FredericChasse/Testbench_PCB/Photos/Testbench_1.jpg

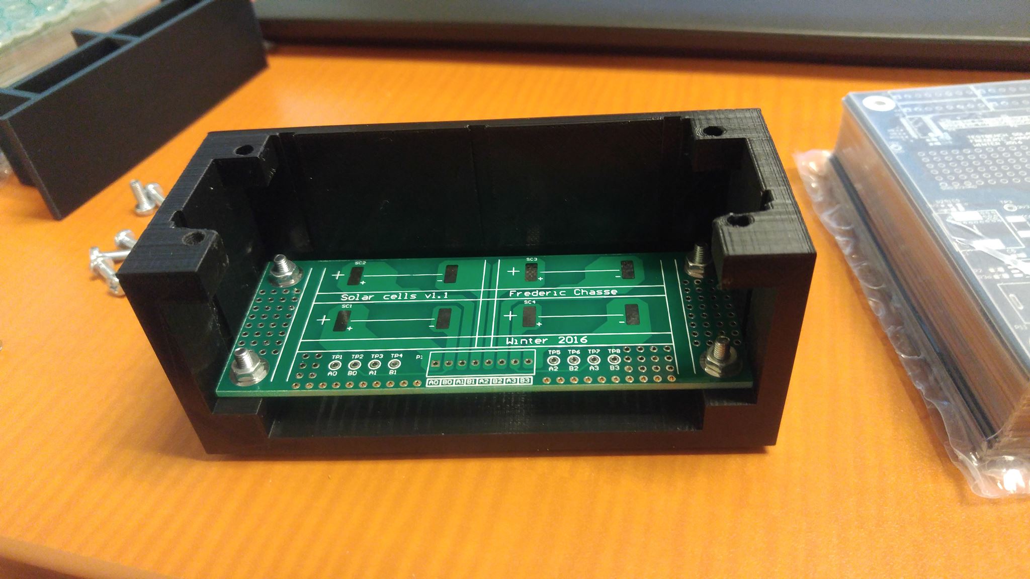
Photos/Testbench_1.jpg
