FredericChasse/Testbench_PCB/Photos/Testbench_2.jpg

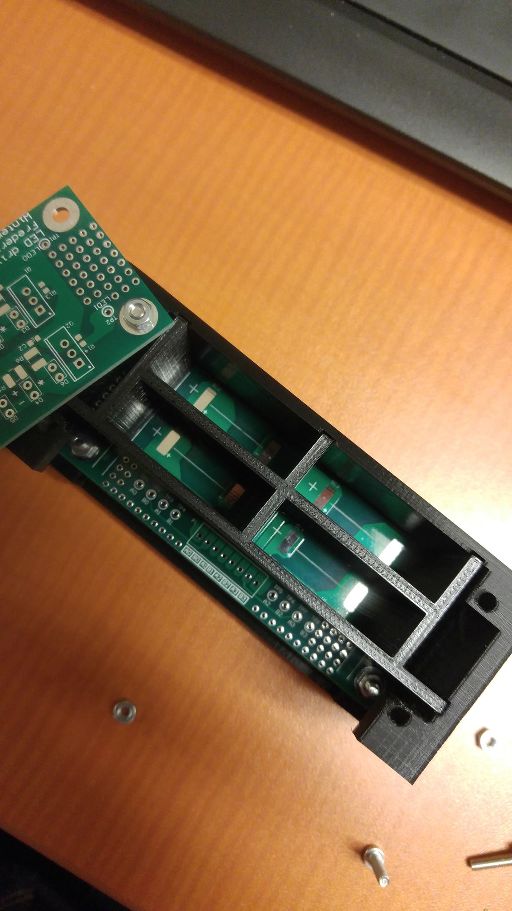
Photos/Testbench_2.jpg
