FredericChasse/Testbench_PCB/README.md

# Testbench_PCB
Schematics of the testbench

Also contains some MATLAB files used is SYS843
