FredericChasse/Testbench_PCB/solar_board/IDFReport_top_level.html

Altium customize

# IDF File Translation Report

Date: | | 2016-01-17
Time: | | 8:56:39 PM
Elapsed Time: | | 00:00:00
PCB Filename | : | C:\Users\ironi\Documents\ETS\Maîtrise\Benchtest solaire\solar_board\top_level.PcbDoc
IDF Board Filename | : | C:\Users\ironi\Documents\ETS\Maîtrise\Benchtest solaire\solar_board\top_level.brd
IDF Library Filename | : | C:\Users\ironi\Documents\ETS\Maîtrise\Benchtest solaire\solar_board\top_level.pro

Errors

Back to top

Warnings

Back to top

Save Warnings

Back to top

Save Errors

Back to top

Export Warnings

Back to top

Export Errors

Back to top
