FredericChasse/Testbench_PCB/ACQ_board.PNG

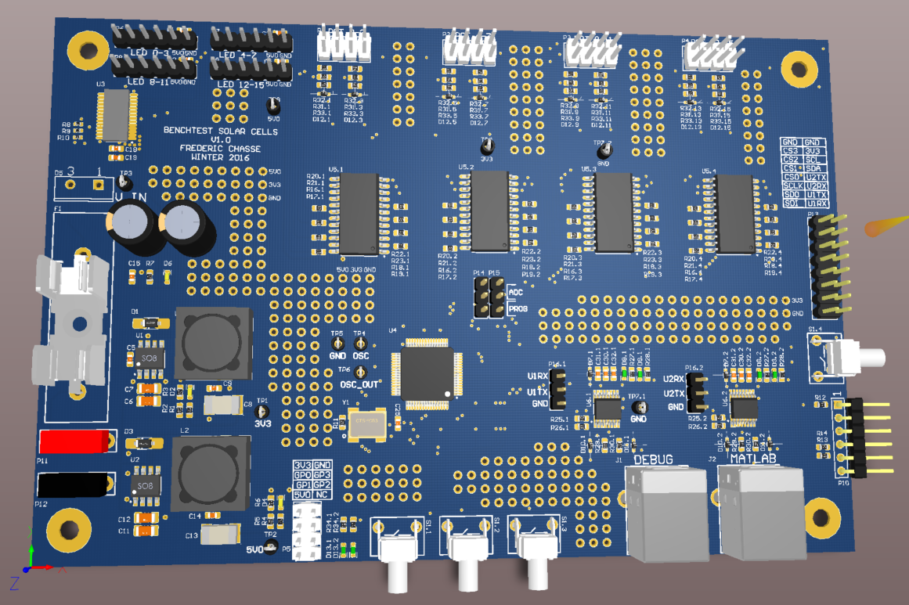
ACQ_board.PNG
