FredericChasse/Testbench_PCB/LED_board.png

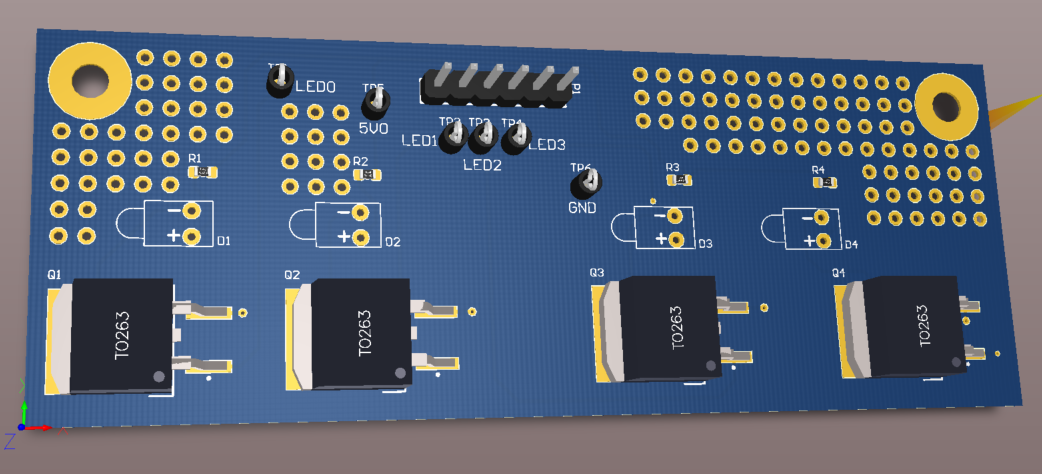
LED_board.png
