FredericChasse/Testbench_PCB/MATLAB/4cells/dc3.jpg

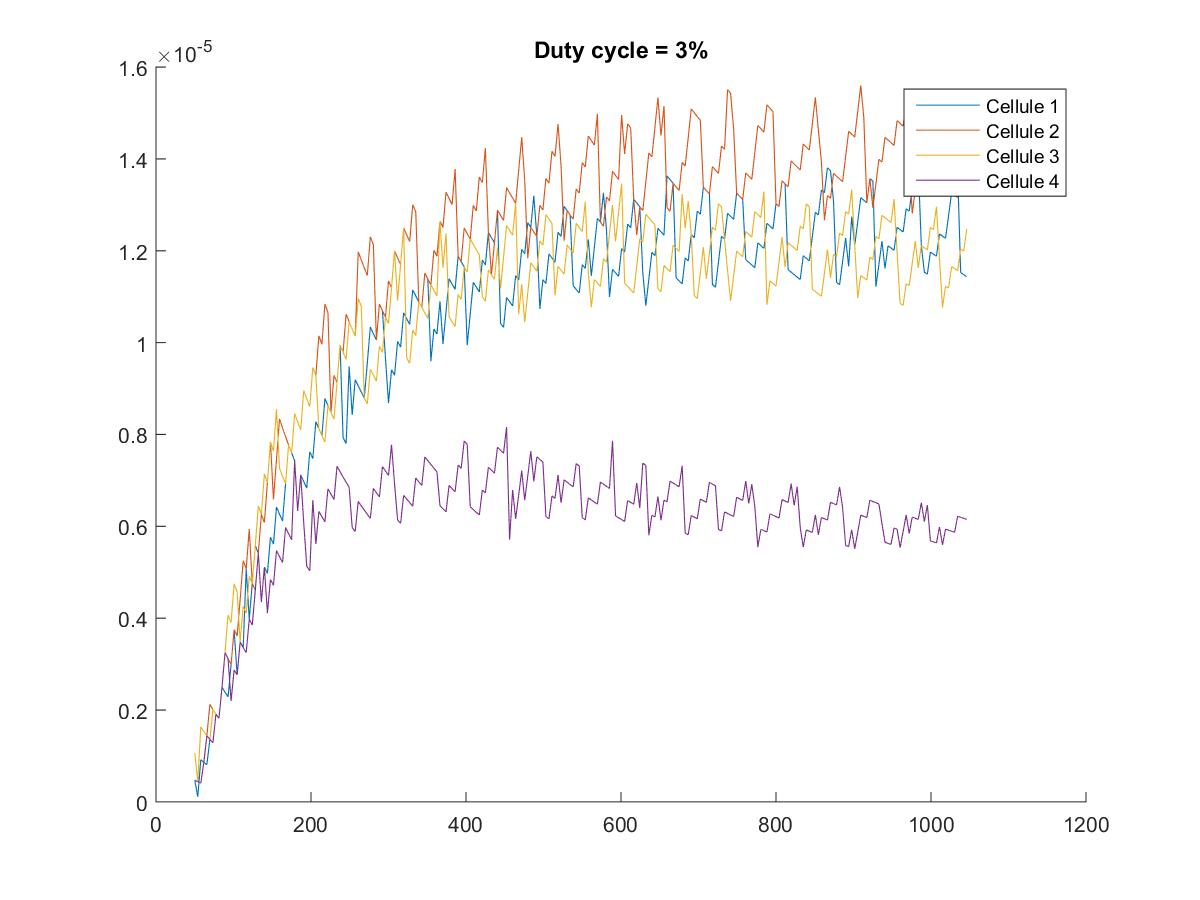
MATLAB/4cells/dc3.jpg
