FredericChasse/Testbench_PCB/MATLAB/4cells/dc5.jpg

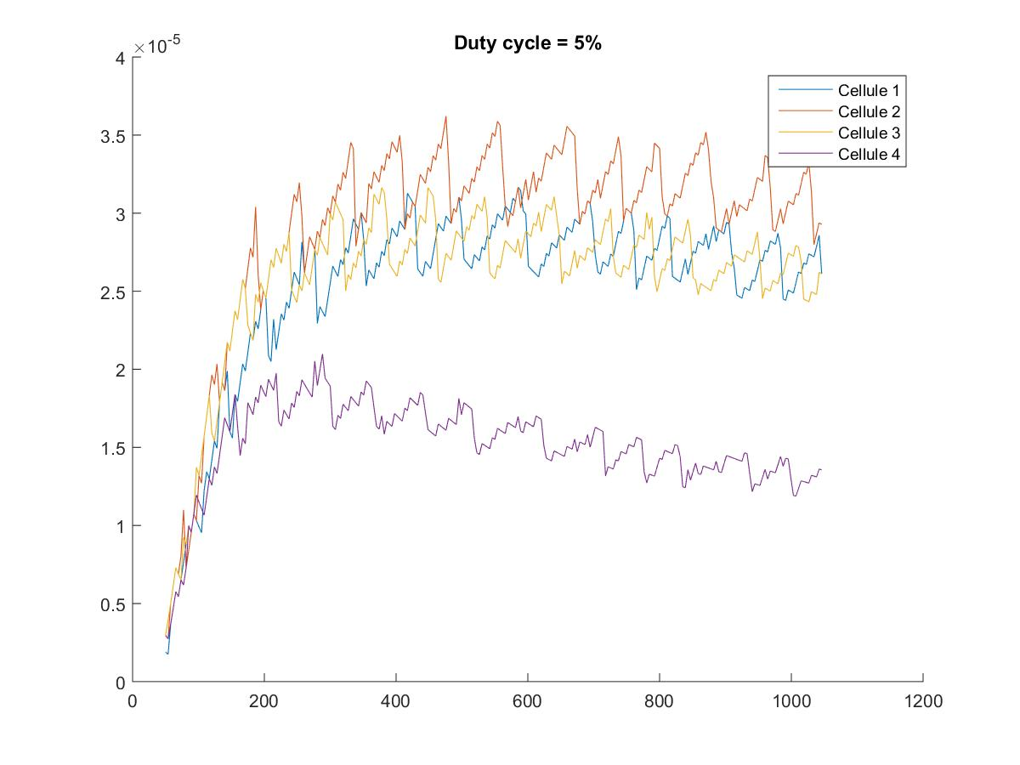
MATLAB/4cells/dc5.jpg
