FredericChasse/Testbench_PCB/MATLAB/4cells/dc10.jpg

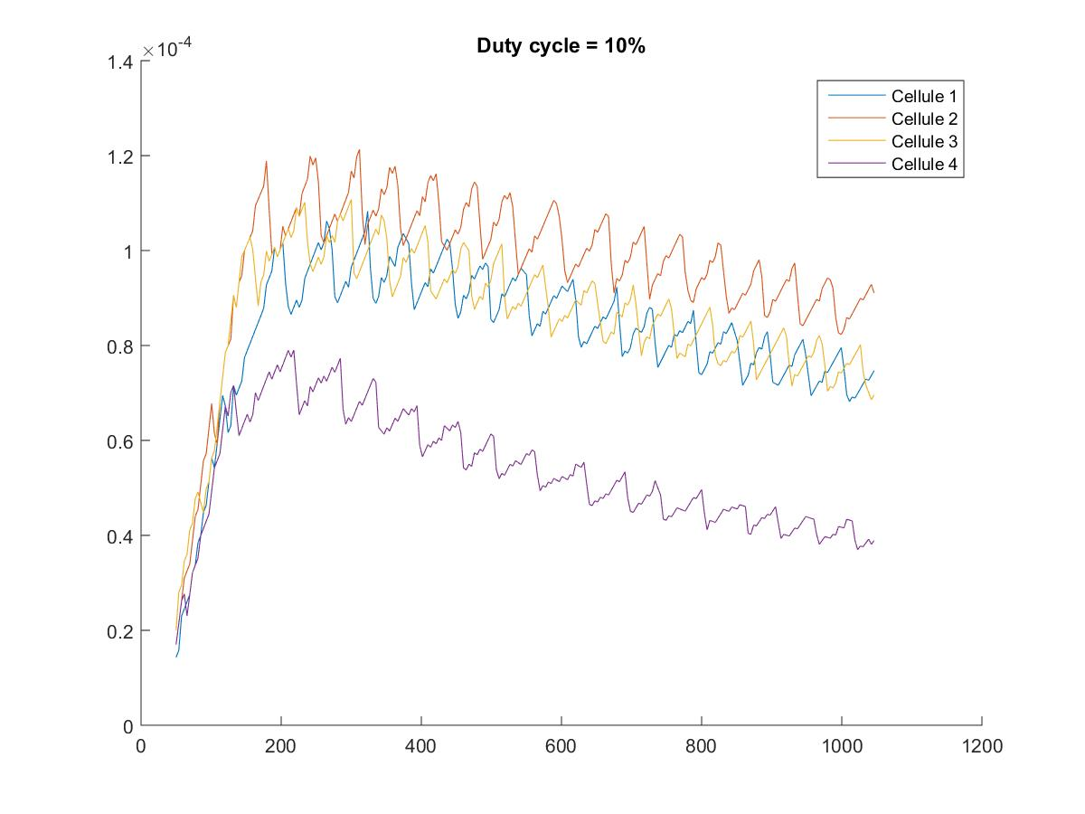
MATLAB/4cells/dc10.jpg
