FredericChasse/Testbench_PCB/MATLAB/4cells/dc15.jpg

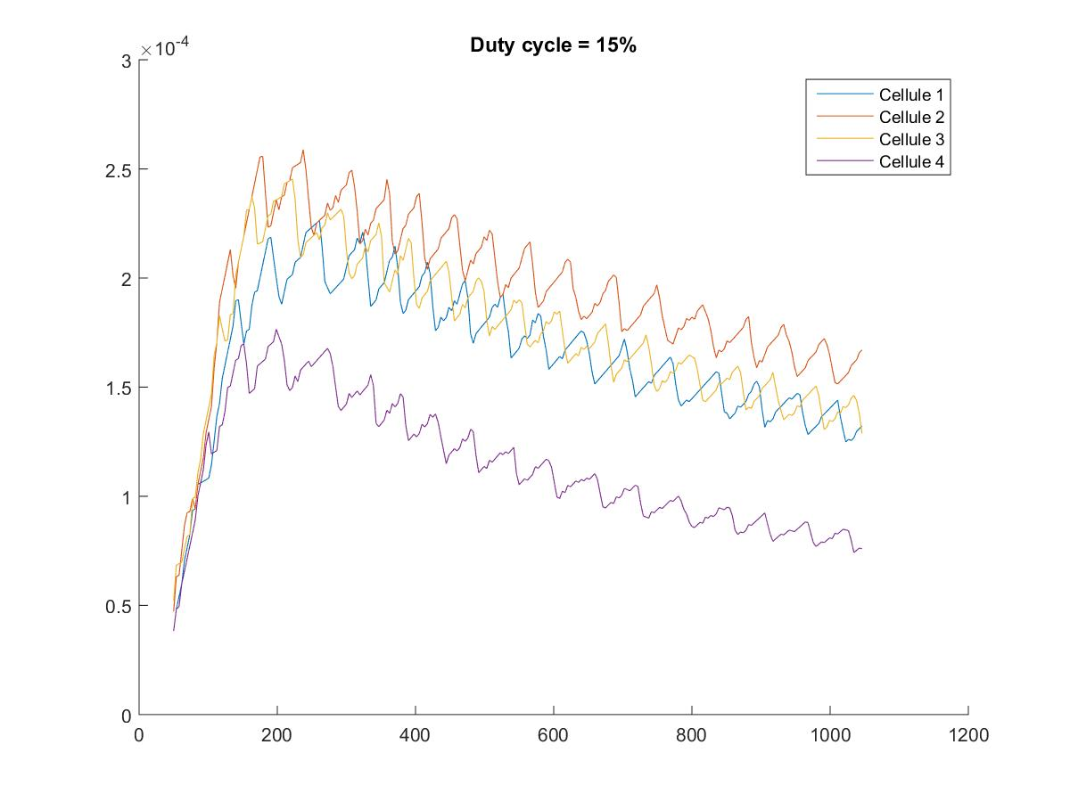
MATLAB/4cells/dc15.jpg
