FredericChasse/Testbench_PCB/MATLAB/4cells/dc20.jpg

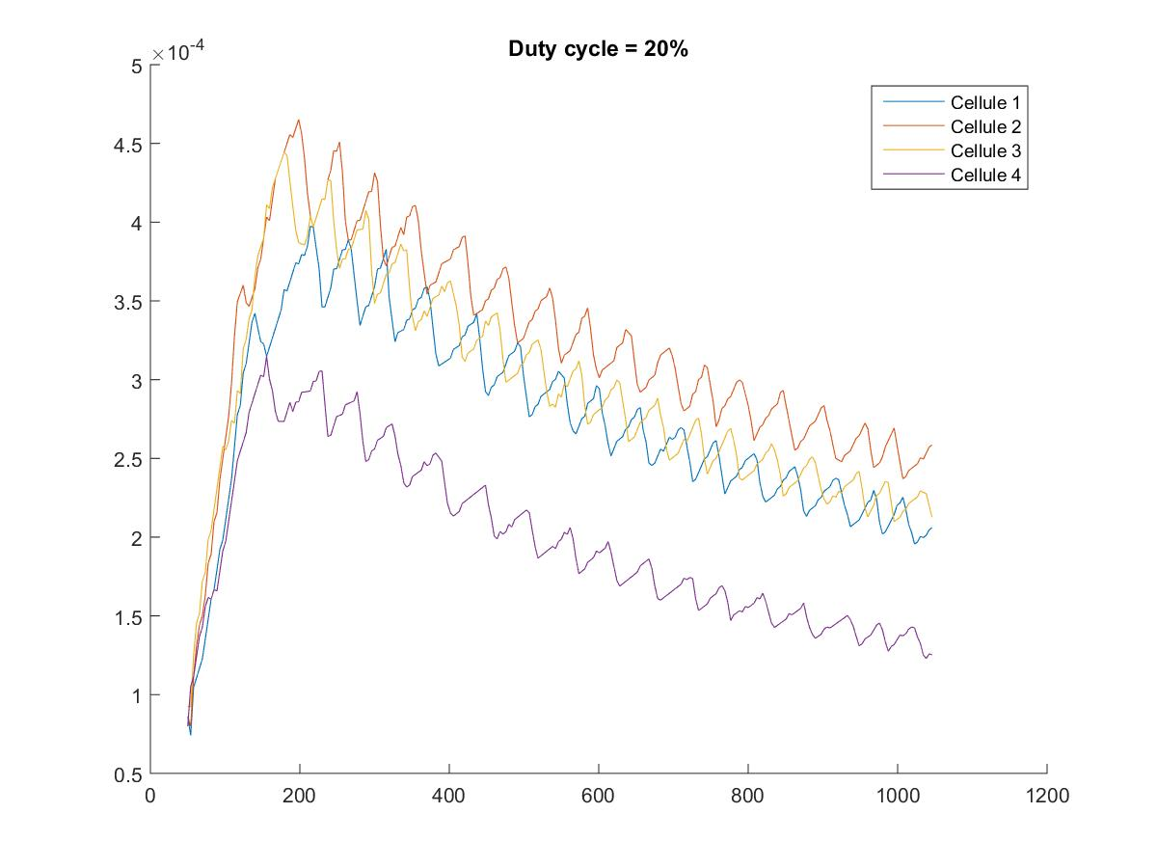
MATLAB/4cells/dc20.jpg
