FredericChasse/Testbench_PCB/MATLAB/4cells/dc30.jpg

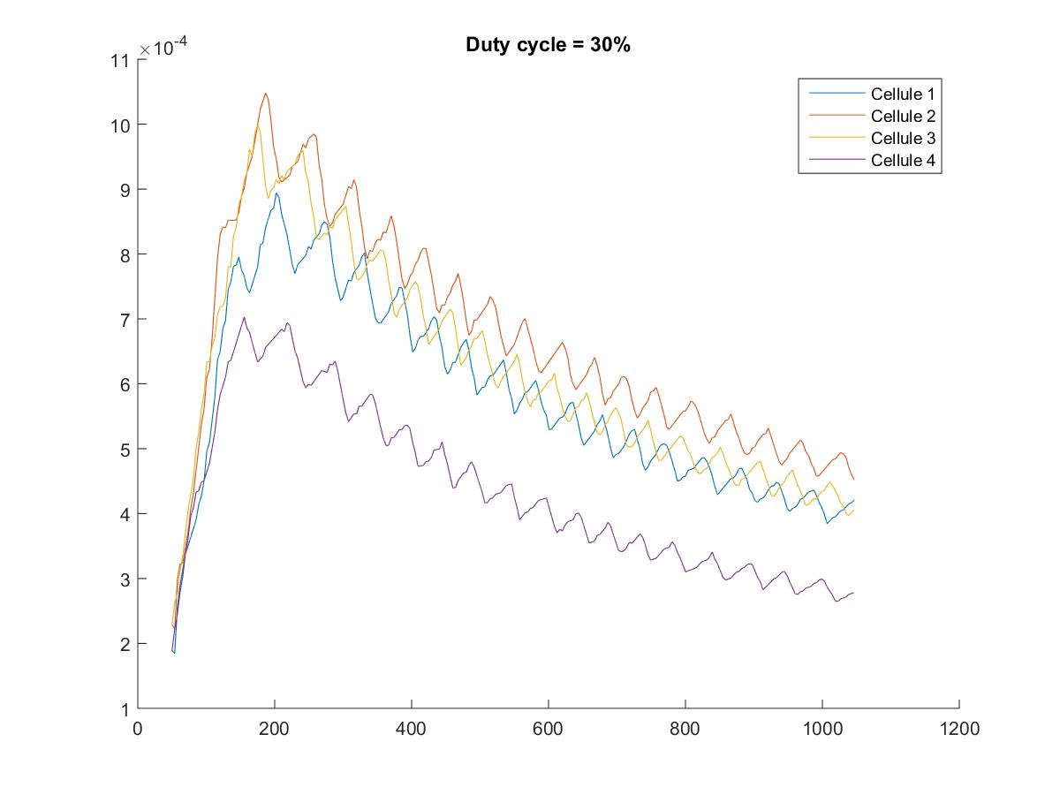
MATLAB/4cells/dc30.jpg
