FredericChasse/Testbench_PCB/MATLAB/4cells/dc40.jpg

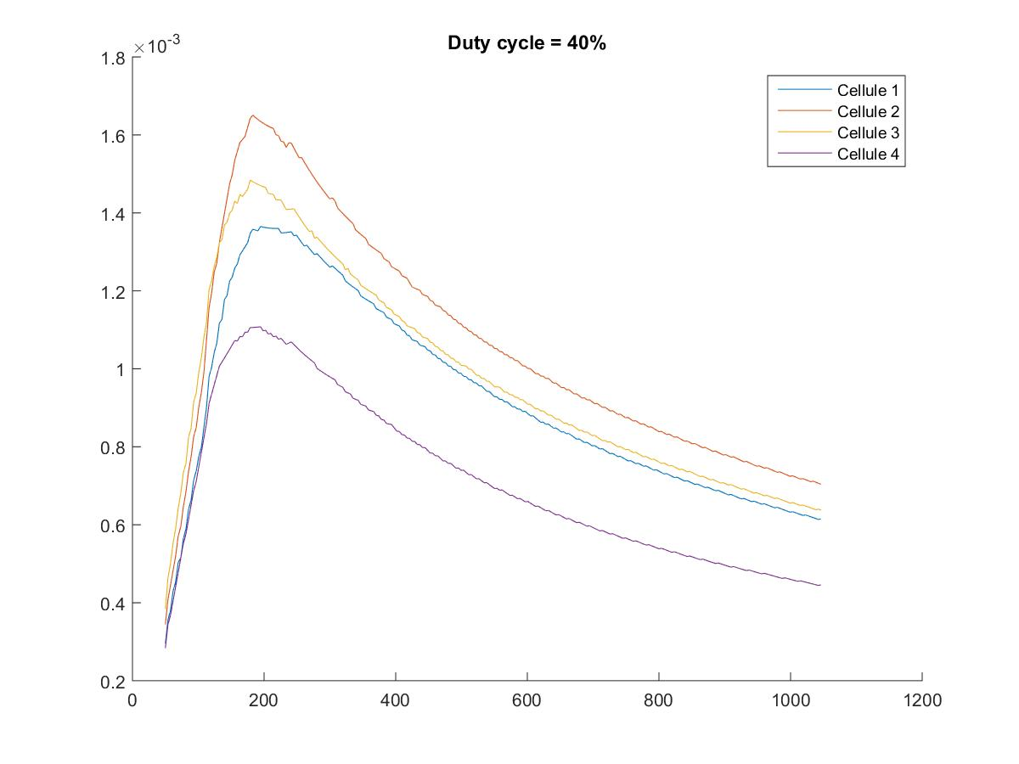
MATLAB/4cells/dc40.jpg
