FredericChasse/Testbench_PCB/MATLAB/dc2_5.jpg

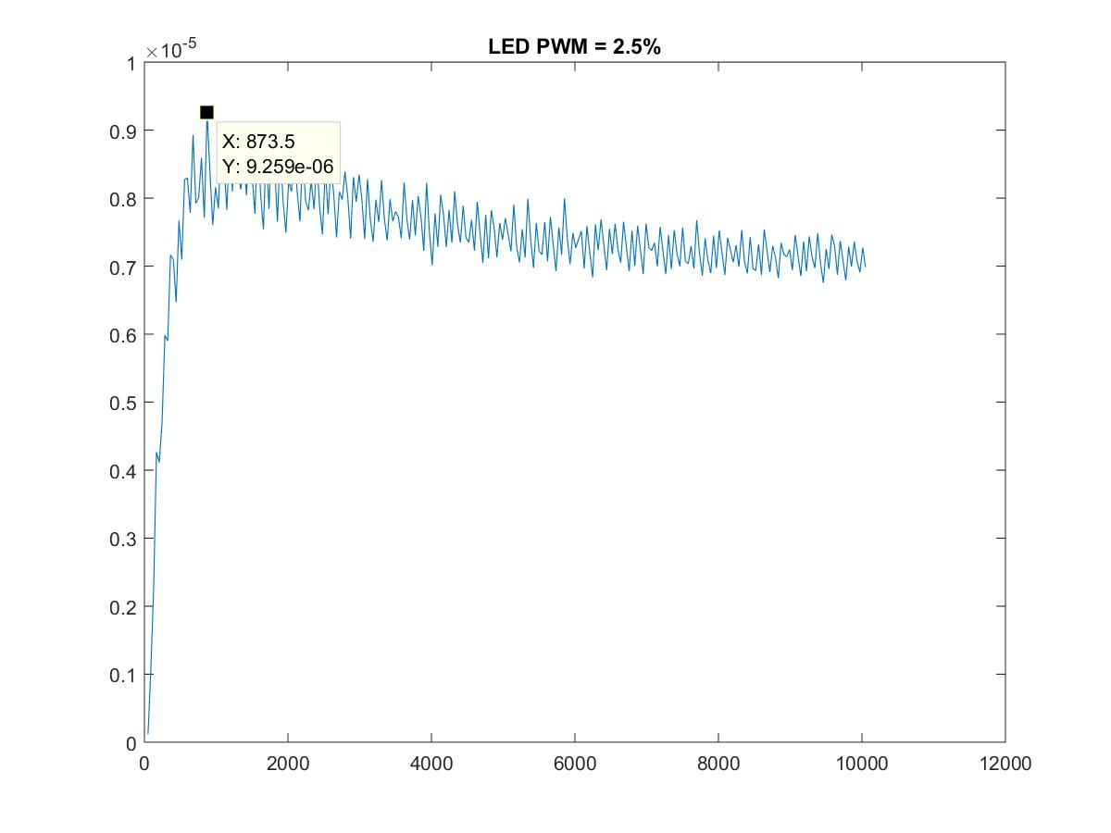
MATLAB/dc2_5.jpg
