FredericChasse/Testbench_PCB/MATLAB/dc5.jpg

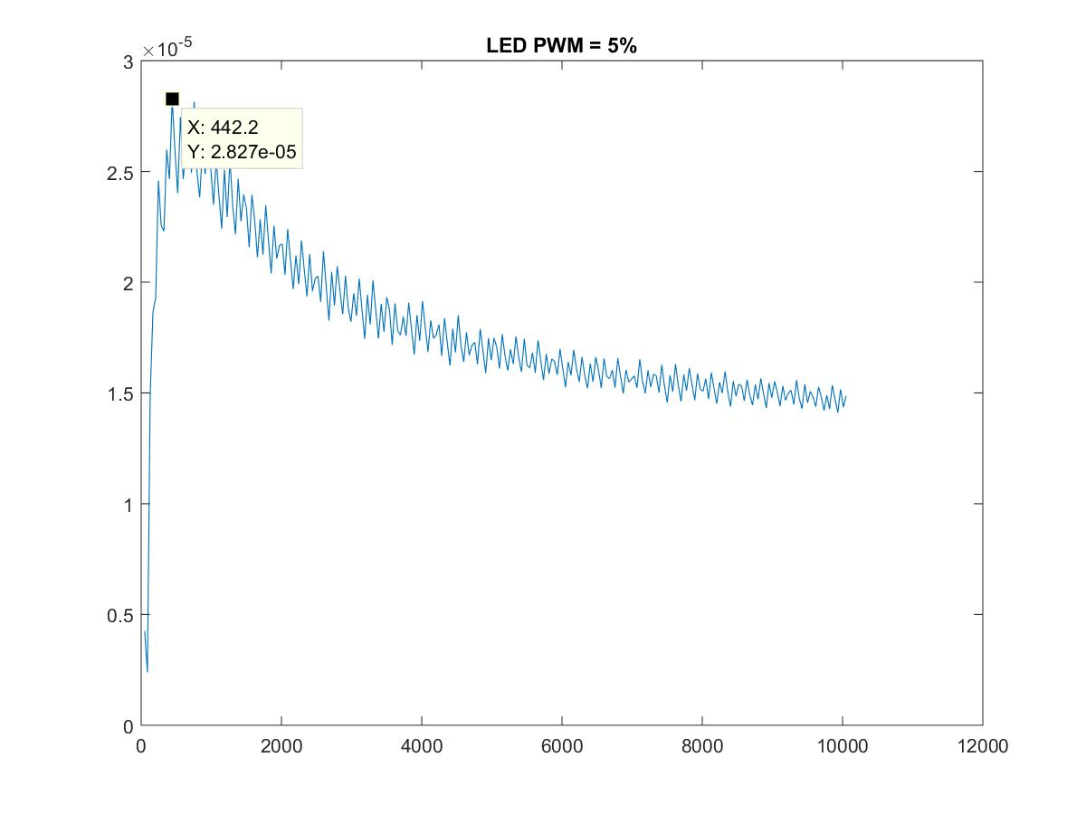
MATLAB/dc5.jpg
