FredericChasse/Testbench_PCB/MATLAB/dc10.jpg

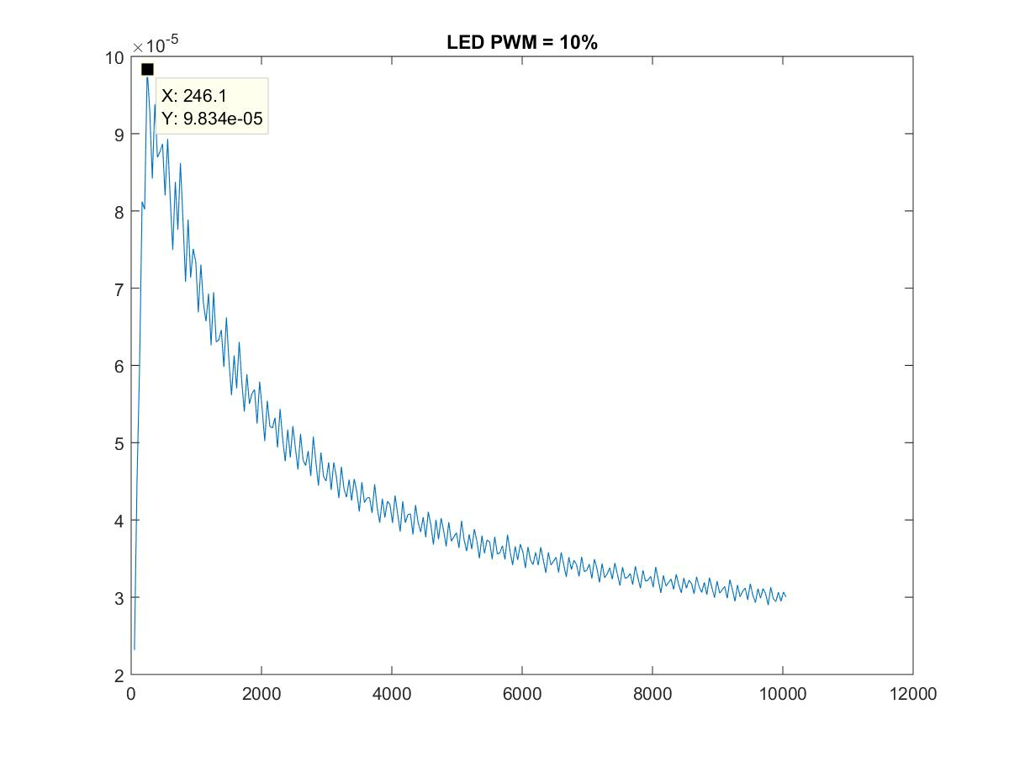
MATLAB/dc10.jpg
