FredericChasse/Testbench_PCB/MATLAB/dc20.jpg

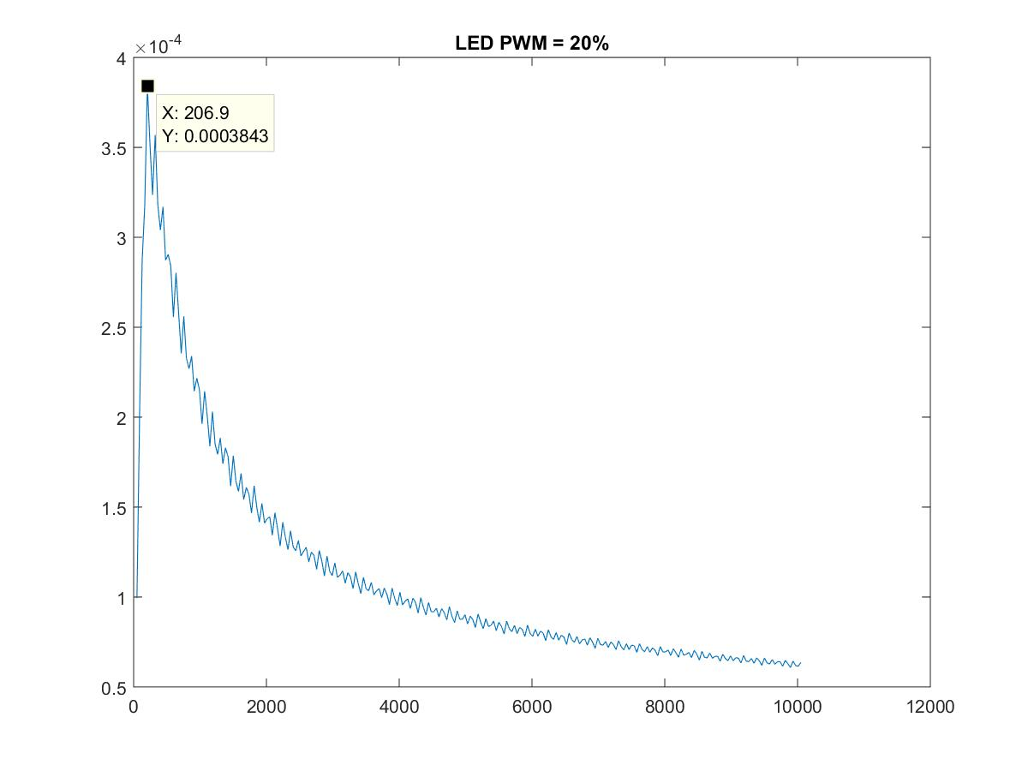
MATLAB/dc20.jpg
