FredericChasse/Testbench_PCB/MATLAB/dc30.jpg

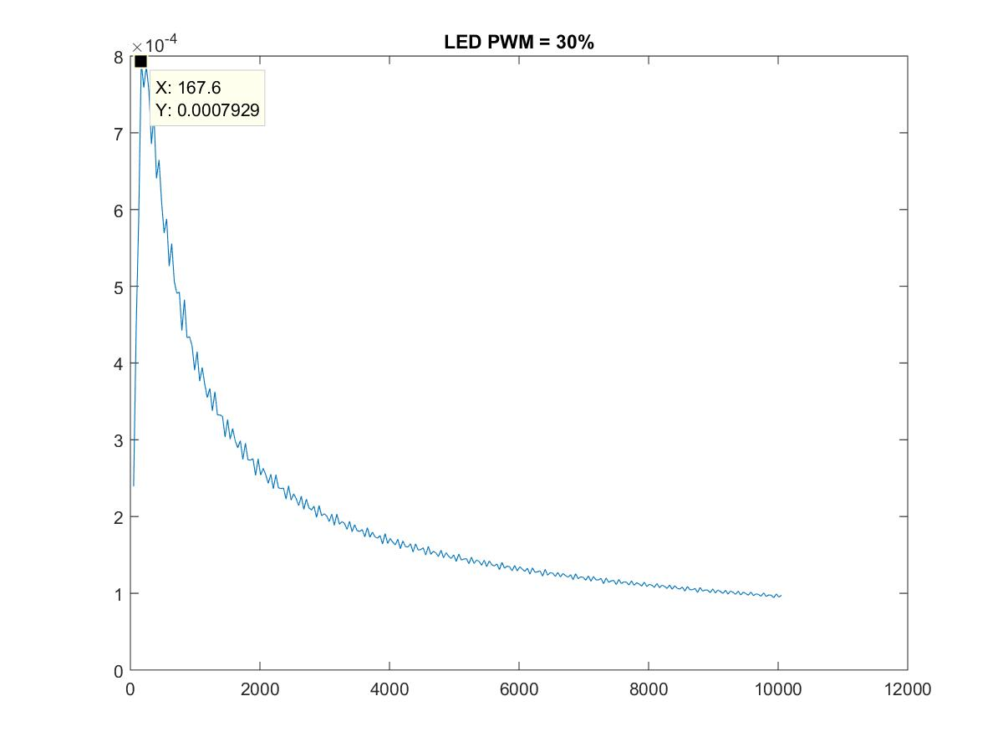
MATLAB/dc30.jpg
