FredericChasse/Testbench_PCB/MATLAB/dc50.jpg

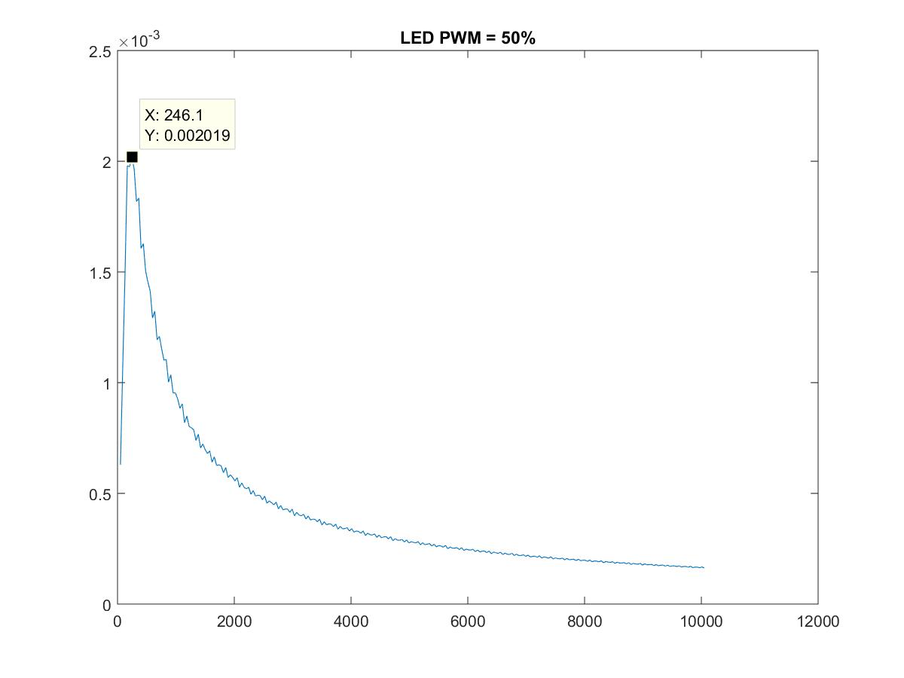
MATLAB/dc50.jpg
