FredericChasse/Testbench_PCB/MATLAB/pot1k/dc20.jpg

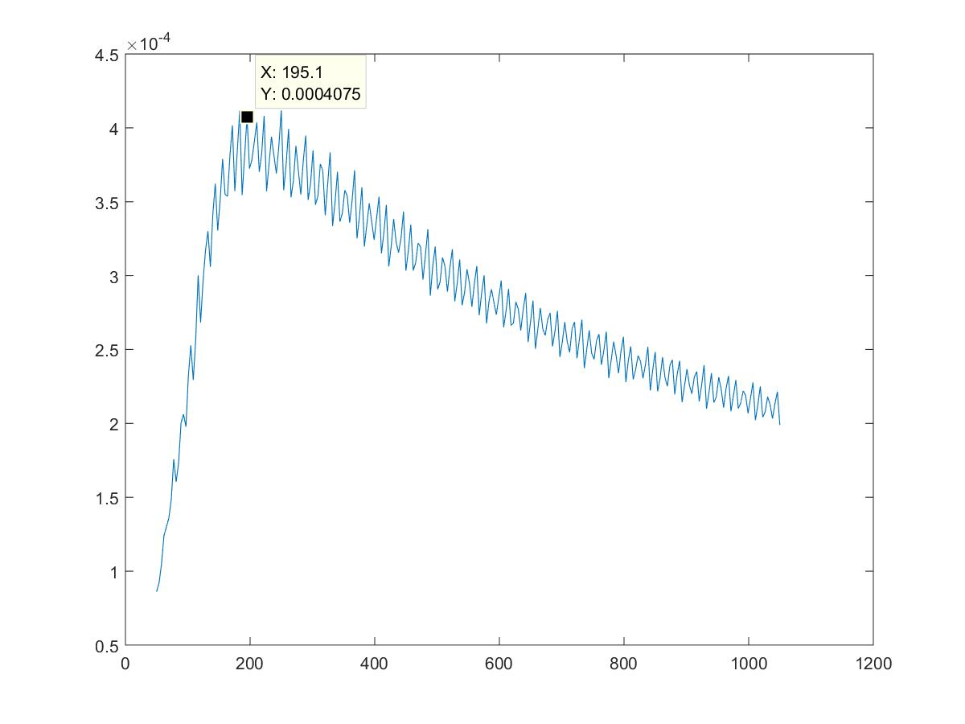
MATLAB/pot1k/dc20.jpg
