FredericChasse/Testbench_PCB/MATLAB/pot1k/dc40.jpg

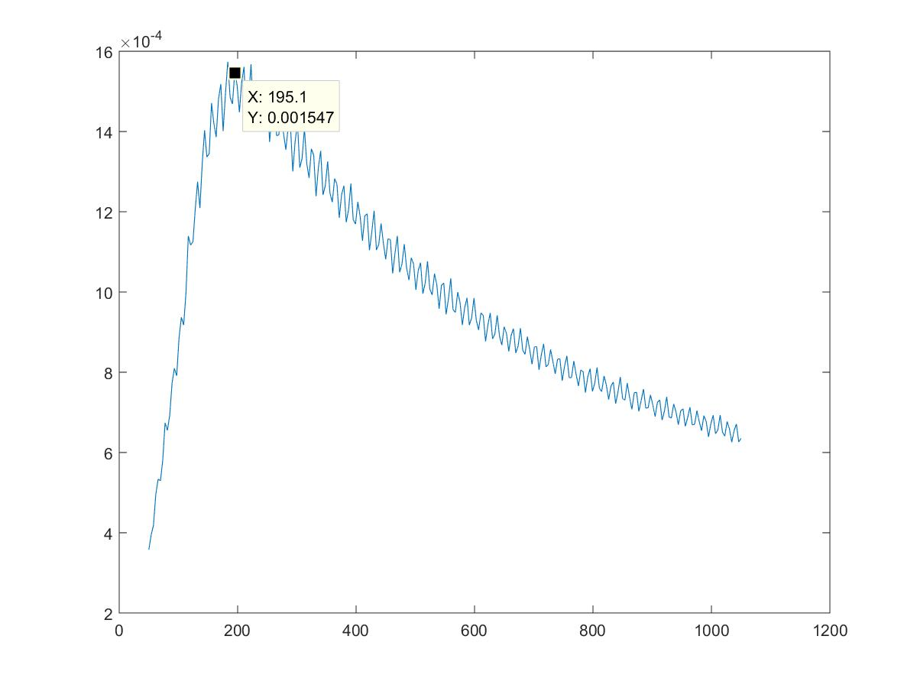
MATLAB/pot1k/dc40.jpg
