FredericChasse/Testbench_PCB/MATLAB/pot1k/dc50.jpg

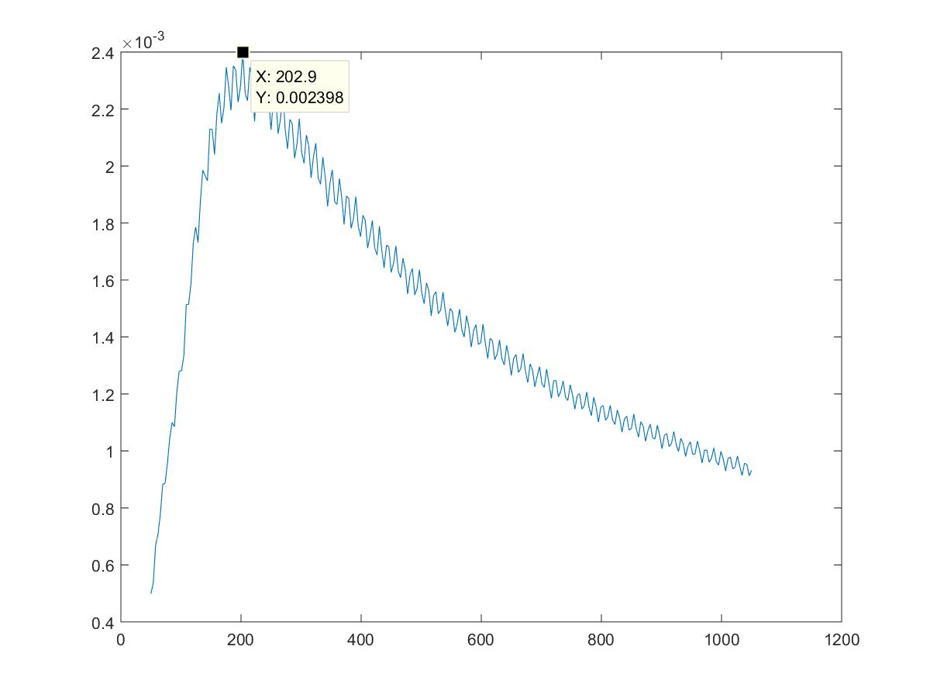
MATLAB/pot1k/dc50.jpg
