FredericChasse/Testbench_PCB/Photos/PCBs.jpg

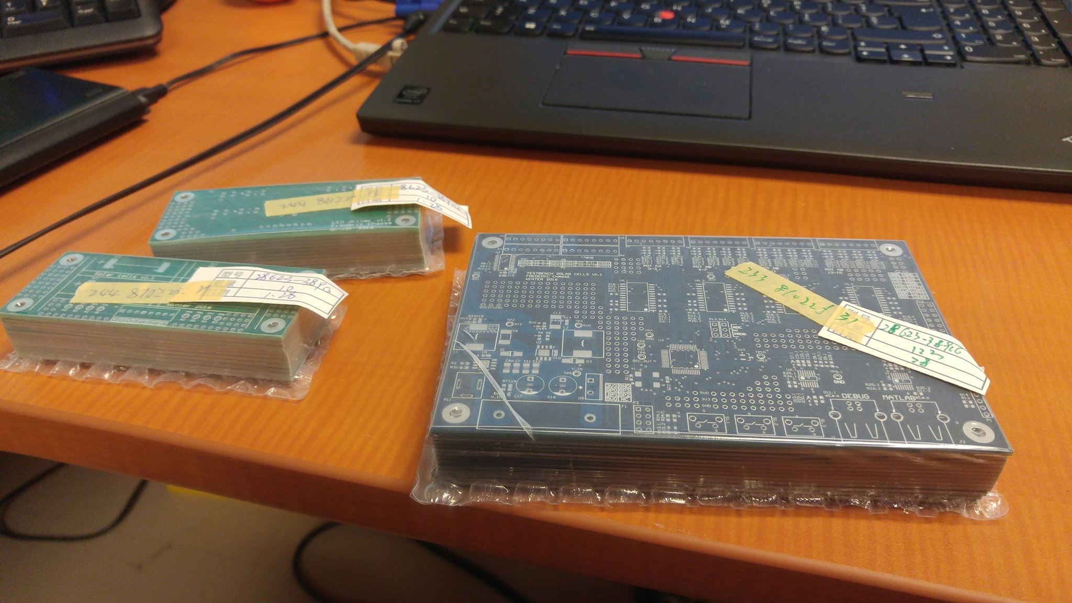
Photos/PCBs.jpg
