FredericChasse/Testbench_PCB/Solar_cells_board.PNG

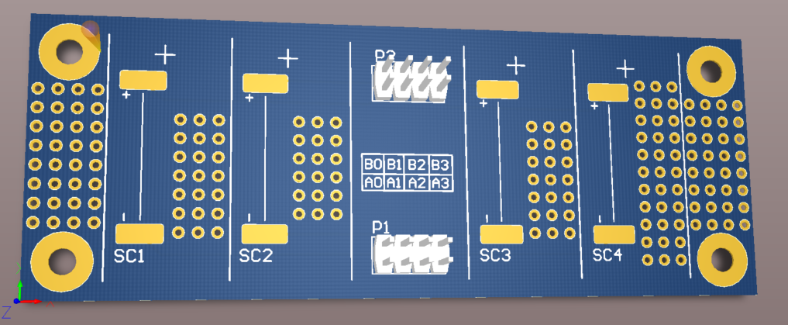
Solar_cells_board.PNG
