FredericChasse/Testbench_PCB/Solidworks/top view.PNG

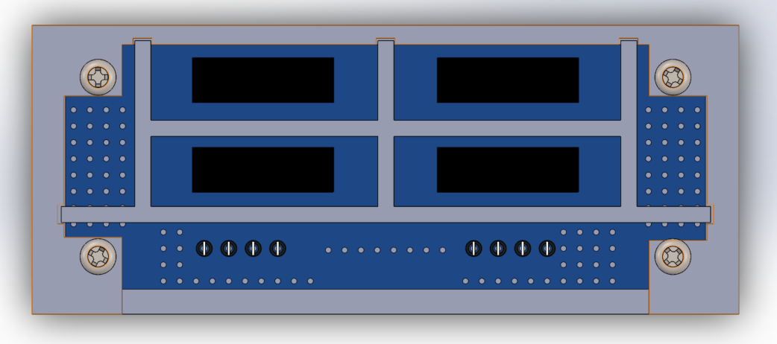
Solidworks/top view.PNG
