FredericChasse/Testbench_PCB/BOM.xlsx

Comment | Description | Designator | Footprint | LibRef | Manufacturer | Part Number | Quantity | DocumentName | Supplier 1 | Supplier 2 | Supplier Part Number 1 | Supplier Part Number 2 | VALUE
CON - HEADER 1X8 | 100mil header 1 row 6 pins | P3, P4, P5, P6, P7, P8, P9, P10 | CON-HEADER-1X8 | CON - HEADER 1X8 |  |  | 8 | ControlBoard.SchDoc | Digi-Key |  | A1924-ND
CON - HEADER 2X4 | 100mil header 2 row 8pins | P2 | CON-HEADER-2X4 | CON - HEADER 2X4 |  |  | 1 | ControlBoard.SchDoc | Digi-Key |  | 952-2122-ND
CON - HEADER 2X8 | 100mil header 2 row 16pins | P12 | CON-HEADER-2X8 | CON - HEADER 2X8 |  |  | 1 | ControlBoard.SchDoc | Digi-Key |  | 952-2128-ND
CON - HEADER PROG | MICROCHIP CONNECTOR | P1 | CON-HEADER-1X6-RA | CON - PROG HEADER 6 |  |  | 1 | ControlBoard.SchDoc | Digi-Key |  | S9016E-06-ND
CON - POWER CONNECTOR | CONN PWR JACK 2.1X5.5MM HIGH CUR | P11 | CON-POWER CONNECTOR | CON - POWER CONNECTOR |  |  | 1 | ControlBoard.SchDoc | Digi-Key |  | CP-002AH-ND
USB 4 pins | 4 pin USB connector with 2 shield pins | J1, J2 | CON-USB TYPE B | CON - USB TYPE B 4 pins | FCI |  | 2 | ControlBoard.SchDoc | Digi-Key |  | 609-3656-ND
CS - CAPACITOR | CAP CER 10000PF 50V 10% X7R 0603 | C1, C2, C3, C4, C5, C9, C10, C14, C15, C18, C19, C20, C21, C22, C23, C24, C25, C26, C27, C28.1, C28.2, C28.3, C28.4, C29.1, C29.2, C29.3, C29.4, C30.1, C30.2, C31.1, C31.2, C32.1, C32.2, C33 | CS-0603 | CS - CAPACITOR | TDK |  | 34 | ControlBoard.SchDoc, ControlBoard.SchDoc, ControlBoard.SchDoc, ControlBoard.SchDoc, DC-DC.SchDoc, DC-DC.SchDoc, DC-DC.SchDoc, DC-DC.SchDoc, DC-DC.SchDoc, LED_Controller.SchDoc, LED_Controller.SchDoc, PIC32MX_circuit.SchDoc, PIC32MX_circuit.SchDoc, PIC32MX_circuit.SchDoc, PIC32MX_circuit.SchDoc, PIC32MX_circuit.SchDoc, PIC32MX_circuit.SchDoc, PIC32MX_circuit.SchDoc, PIC32MX_circuit.SchDoc, Potentiometer.SchDoc, Potentiometer.SchDoc, Potentiometer.SchDoc, Potentiometer.SchDoc, Push_Button.SchDoc, Push_Button.SchDoc, Push_Button.SchDoc, Push_Button.SchDoc, USB-UART.SchDoc, USB-UART.SchDoc, USB-UART.SchDoc, USB-UART.SchDoc, USB-UART.SchDoc, USB-UART.SchDoc, Vref.SchDoc | Digikey |  | 445-1311-1-ND, 490-1532-1-ND |  | 100n, 100n, 100n, 100n, 10nF, 100n, 10nF, 100n, 1uF, 100n, 100n, 100n, 100n, 100n, 100n, 100n, 100n, 10u, 100n, 100n, 100n, 100n, 100n, 100n, 100n, 100n, 100n, 4.7u, 4.7u, 100n, 100n, 100n, 100n, 100n
5003K |  | TP1, TP2, TP3, TP4, TP5, TP6, TP7, TP8, TP9.1, TP9.2, TP10 | TP - VERTICAL | TP - Test point vertical |  |  | 11 | ControlBoard.SchDoc, ControlBoard.SchDoc, DC-DC.SchDoc, DC-DC.SchDoc, DC-DC.SchDoc, PIC32MX_circuit.SchDoc, PIC32MX_circuit.SchDoc, PIC32MX_circuit.SchDoc, USB-UART.SchDoc, USB-UART.SchDoc, Vref.SchDoc | Newark, Digikey |  | 62W5140, 5004K-ND
B340A-13-F | DIODE SCHOTTKY 40V 3A SMA | D1, D3 | DS-DO-214AC-SMA | DS - Schottky | Diodes Incorporated |  | 2 | DC-DC.SchDoc | Digikey | Digi-Key | B340A-FDICT-ND | B340A-FDICT-ND (https://octopart-clicks.com/click/altium?sku=B340A-FDICT-ND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)
CS - CAPACITOR |  | C6, C7, C11, C12 | CS-1206 | CS - CAPACITOR | Samsung |  | 4 | DC-DC.SchDoc | Digikey |  | 587-2994-1-ND |  | 4.7uF
CS - CAPACITOR POL |  | C8, C13 | CS-2312 | CS - CAPACITOR POL |  |  | 2 | DC-DC.SchDoc |  | Digi-Key | 478-5236-2-ND | 478-5236-1-ND (https://octopart-clicks.com/click/altium?sku=478-5236-1-ND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) | 220u
CT - CAPACITOR ELECTROLYTIC |  | C16, C17 | CT-CAP-ALUM-8X14 | CT - CAPACITOR ELECTROLYTIC |  |  | 2 | DC-DC.SchDoc |  | Digi-Key | 493-13402-ND |  | 100uF
DT - Diode | Zener Schottky | D5 | TO-220AC | Diode 18TQ045 |  |  | 1 | DC-DC.SchDoc |  | Digi-Key | MBR1645-E3/45GI-ND | MBR1645-E3/45GI-ND (https://octopart-clicks.com/click/altium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)
FT - Fuse |  | F1 | FT - 5mm x 20mm | FT - Fuse | Schurter Inc |  | 1 | DC-DC.SchDoc | Digikey |  | 486-1259-ND
IC - TPS5430 | IC REG BUCK ADJ 3A 8SOPWRPAD | U1, U2 | IC-SOIC8-POWERPAD | IC - TPS5430 | Texas Instruments | TPS5430 | 2 | DC-DC.SchDoc | Digi-Key |  | 296-26988-1-ND
LED - NORMAL LED |  | D2, D4, D6 | LED-0603 YELLOW | LED - NORMAL LED |  |  | 3 | DC-DC.SchDoc |  | Digi-Key | 160-1445-1-ND
LS - INDUCTOR | INDUCTOR SHIELD PWR | L1, L2 | LS-Inductor SMD | LS - INDUCTOR | Bourns Inc |  | 2 | DC-DC.SchDoc | Digikey |  | SRR1260-330M |  | 33uH
RS - RESISTOR |  | R1, R2, R3, R4, R5, R6, R7, R11, R12, R13, R14, R15, R16.1, R16.2, R16.3, R16.4, R17.1, R17.2, R17.3, R17.4, R18.1, R18.2, R18.3, R18.4, R19.1, R19.2, R19.3, R19.4, R20.1, R20.2, R20.3, R20.4, R21.1, R21.2, R21.3, R21.4, R22.1, R22.2, R22.3, R22.4, R23.1, R23.2, R23.3, R23.4, R24.1, R24.2, R24.3, R24.4, R25.1, R25.2, R26.1, R26.2, R27.1, R27.2, R28.1, R28.2, R29.1, R29.2, R30.1, R30.2, R31.1, R31.2, R31.3, R31.4, R31.5, R31.6, R31.7, R31.8, R31.9, R31.10, R31.11, R31.12, R31.13, R31.14, R31.15, R32.1, R32.2, R32.3, R32.4, R32.5, R32.6, R32.7, R32.8, R32.9, R32.10, R32.11, R32.12, R32.13, R32.14, R32.15, R33.1, R33.2, R33.3, R33.4, R33.5, R33.6, R33.7, R33.8, R33.9, R33.10, R33.11, R33.12, R33.13, R33.14, R33.15, R34.1, R34.2, R35 | RS-0603 | RS - RESISTOR |  |  | 108 | DC-DC.SchDoc, DC-DC.SchDoc, DC-DC.SchDoc, DC-DC.SchDoc, DC-DC.SchDoc, DC-DC.SchDoc, DC-DC.SchDoc, PIC32MX_circuit.SchDoc, PIC32MX_circuit.SchDoc, PIC32MX_circuit.SchDoc, PIC32MX_circuit.SchDoc, PIC32MX_circuit.SchDoc, Potentiometer.SchDoc, Potentiometer.SchDoc, Potentiometer.SchDoc, Potentiometer.SchDoc, Potentiometer.SchDoc, Potentiometer.SchDoc, Potentiometer.SchDoc, Potentiometer.SchDoc, Potentiometer.SchDoc, Potentiometer.SchDoc, Potentiometer.SchDoc, Potentiometer.SchDoc, Potentiometer.SchDoc, Potentiometer.SchDoc, Potentiometer.SchDoc, Potentiometer.SchDoc, Potentiometer.SchDoc, Potentiometer.SchDoc, Potentiometer.SchDoc, Potentiometer.SchDoc, Potentiometer.SchDoc, Potentiometer.SchDoc, Potentiometer.SchDoc, Potentiometer.SchDoc, Potentiometer.SchDoc, Potentiometer.SchDoc, Potentiometer.SchDoc, Potentiometer.SchDoc, Potentiometer.SchDoc, Potentiometer.SchDoc, Potentiometer.SchDoc, Potentiometer.SchDoc, Push_Button.SchDoc, Push_Button.SchDoc, Push_Button.SchDoc, Push_Button.SchDoc, USB-UART.SchDoc, USB-UART.SchDoc, USB-UART.SchDoc, USB-UART.SchDoc, USB-UART.SchDoc, USB-UART.SchDoc, USB-UART.SchDoc, USB-UART.SchDoc, USB-UART.SchDoc, USB-UART.SchDoc, USB-UART.SchDoc, USB-UART.SchDoc, Signal_Protection.SchDoc, Signal_Protection.SchDoc, Signal_Protection.SchDoc, Signal_Protection.SchDoc, Signal_Protection.SchDoc, Signal_Protection.SchDoc, Signal_Protection.SchDoc, Signal_Protection.SchDoc, Signal_Protection.SchDoc, Signal_Protection.SchDoc, Signal_Protection.SchDoc, Signal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 |  |  | http://www.digikey.ca/product-search/en/resistors/chip-resistor-surface-mount/65769?k=resistor |  | 130, 10K, 5.90K, 300, 10K, 3.24K, 2K, 10k, 100, 47, 47, 0, 0, 0, 0, 0, 0, 0, 0, 0, 0, 0, 0, 0, 0, 0, 0, 0, 0, 0, 0, 0, 0, 0, 0, 0, 0, 0, 0, 0, 0, 0, 0, 0, 10k, 10k, 10k, 10k, 10k, 10k, 10k, 10k, 130, 130, 130, 130, 27, 27, 27, 27, [NoValue], [NoValue], [NoValue], [NoValue], [NoValue], [NoValue], [NoValue], [NoValue], [NoValue], [NoValue], [NoValue], [NoValue], [NoValue], [NoValue], [NoValue], 0, 0, 0, 0, 0, 0, 0, 0, 0, 0, 0, 0, 0, 0, 0, [NoValue], [NoValue], [NoValue], [NoValue], [NoValue], [NoValue], [NoValue], [NoValue], [NoValue], [NoValue], [NoValue], [NoValue], [NoValue], [NoValue], [NoValue], 130, 130, 300R0
IC - PCA9685 | 16-channel, 12-bit PWM Fm + I2C-bus LED controller | U3 | IC-TSSOP-28 | IC - PCA9685 | Allegro |  | 1 | LED_Controller.SchDoc | Digi-Key |  | 568-11925-2-ND
RS - RESISTOR |  | R8, R9, R10 | RS-0402 | RS - RESISTOR |  |  | 3 | LED_Controller.SchDoc |  |  | http://www.digikey.ca/product-search/en/resistors/chip-resistor-surface-mount/65769?k=resistor |  | 10k, 4.7k, 4.7k
8MHz | Oscillator | Y1 | OSC-CB3LV | OSC - CB3LV |  |  | 1 | PIC32MX_circuit.SchDoc | Digi-Key |  | CTX264LVCT-ND
CON - HEADER 1X3 | 100mil header 1 row 3pins | P13, P14 | CON-HEADER-1X3 | CON - HEADER 1X3 |  |  | 2 | PIC32MX_circuit.SchDoc | Digi-Key |  | S1212EC-03-ND
IC - PIC32MX795F512HT-80I/PT |  | U4 | IC-TQFP-64 | IC - PIC32MX795F512HT-80I/PT | Microchip |  | 1 | PIC32MX_circuit.SchDoc | Digi-Key |  | PIC32MX795F512H-80I/PT-ND
IC - AD8403 | DIGITAL POTENTIOMETER | U5.1, U5.2, U5.3, U5.4 | IC-SOIC-24 | IC - AD8403 |  |  | 4 | Potentiometer.SchDoc | Digi-Key |  | AD8403ARZ10-ND
SW - Tactile Switch |  | S1.1, S1.2, S1.3, S1.4 | SW-FSMRA | SW - Tactile Switch |  |  | 4 | Push_Button.SchDoc | Digi-Key | Digi-Key | 450-1658-ND | 450-1758-2-ND (https://octopart-clicks.com/click/altium?sku=450-1758-2-ND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)
DS - TVS ESD5Z3.3T1G | TVS 3.3V | D12.1, D12.2, D12.3, D12.4, D12.5, D12.6, D12.7, D12.8, D12.9, D12.10, D12.11, D12.12, D12.13, D12.14, D12.15 | DS-SOD523 | DS - TVS ESD5Z3.3T1G | ON Semiconductor |  | 15 | Signal_Protection.SchDoc | Digi-Key |  | ESD5Z3.3T1GOSCT-ND
DS - TVS ESD5Z5.0T1G | TVS 5V | D7.1, D7.2, D10.1, D10.2, D11.1, D11.2 | DS-SOD523 | DS - TVS ESD5Z5.0T1G | ON Semiconductor |  | 6 | USB-UART.SchDoc |  | Digi-Key | ESD5Z5.0T1GOSTR-ND | ESD5Z5.0T1GOSCT-ND (https://octopart-clicks.com/click/altium?sku=ESD5Z5.0T1GOSCT-ND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)
IC - FT230XS | USB to BASIC UART IC | U6.1, U6.2 | IC-SSOP-16 | IC - FT230XS | FTDI |  | 2 | USB-UART.SchDoc | Digi-Key |  | 768-1154-5-ND
LED - NORMAL LED |  | D8.1, D8.2, D9.1, D9.2, D13.1, D13.2 | LED-0603 GREEN | LED - NORMAL LED |  |  | 6 | USB-UART.SchDoc, USB-UART.SchDoc, USB-UART.SchDoc, USB-UART.SchDoc, LED_debug.SchDoc, LED_debug.SchDoc |  | Digi-Key | 160-1446-1-ND
DS - LM4040 | Zener Diode Vref | D14 | IC-SOT-23 | DS - LM4040 |  |  | 1 | Vref.SchDoc | Digi-Key |  | LM4040EIM3-2.5/NOPBCT-ND
Solar_board
Comment | Description | Designator | Footprint | LibRef | Quantity | Supplier 1 | Supplier Part Number 1
CON - HEADER 1X8 | 100mil header 1 row 6 pins | P1 | CON-HEADER-1X8 | CON - HEADER 1X8 | 1 | Digi-Key | A1924-ND
RS - RESISTOR VARIABLE |  | SC1, SC2, SC3, SC4 | SC - KXOB22-04X3L | RS - RESISTOR VARIABLE | 4 | Digikey | KXOB22-04X3L-ND
5003K |  | TP1, TP2, TP3, TP4, TP5, TP6, TP7, TP8 | TP - VERTICAL | TP - Test point vertical | 8 | Newark | 62W5140
Led_board
Comment | Description | Designator | Footprint | LibRef | Quantity | Supplier name | Supplier Part Number | VALUE | Supplier 1 | Supplier Part Number 1
CT - CAPACITOR ELECTROLYTIC |  | C1 | CT-CAP-ALUM-8X14 | CT - CAPACITOR ELECTROLYTIC | 1 | Digikey | 493-13402-ND | 100uF | Digikey | 493-13402-ND
CS - CAPACITOR |  | C2, C3, C4, C5 | CS-0603 | CS - CAPACITOR | 4 |  |  | 100n | Digikey | 445-1311-1-ND, 490-1532-1-ND
LED - NORMAL LED |  | D1, D2, D3, D4, D5, D6, D7, D8 | LED-1 | LED - NORMAL LED | 12 |  |  |  | Digikey | VLCS5830-ND
CON - HEADER 1X8 | 100mil header 1 row 6 pins | P1 | CON-HEADER-1X8 | CON - HEADER 1X8 | 1 |  |  |  | Digi-Key | A1924-ND
MOSFET-N | N-Channel MOSFET | Q1, Q2, Q3, Q4 | TO-220AB | MOSFET-N | 4 | Digikey | IRFI530NPBF-ND
RS - RESISTOR |  | R1, R2, R3, R4, R5, R6, R7, R8 | RS-1210 | RS - RESISTOR | 12 |  |  | 28 | Digikey | P28.0AACT-ND
RS - RESISTOR |  | R9, R10, R11, R12 | RS-0603 | RS - RESISTOR | 4 |  |  | 10k | Digikey | http://www.digikey.ca/product-search/en/resistors/chip-resistor-surface-mount/65769?k=resistor
5003K |  | TP1, TP2, TP3, TP4, TP5, TP6 | TP - VERTICAL | TP - Test point vertical | 6 |  |  |  | Newark | 62W5140
 | http://www.digikey.ca/short/373v85
 | http://www.digikey.ca/short/37qtdv | shortened
 | http://www.digikey.ca/short/37z8nf | without samples
 | http://www.digikey.ca/short/37h0h9 | 56 ohm
 | http://www.digikey.ca/short/3t77rm
