FredericChasse/Testbench_PCB/solar_board/Project Outputs for solar_board/solar_board.xlsx

Comment | Description | Designator | Footprint | LibRef | Quantity | Supplier 1 | Supplier Part Number 1
CON - HEADER 1X8 | 100mil header 1 row 6 pins | P1 | CON-HEADER-1X8 | CON - HEADER 1X8 | 1 | Digi-Key | A1924-ND (https://octopart-clicks.com/click/altium?manufacturer=TE%20Connectivity%20AMP%20Connectors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)
RS - RESISTOR VARIABLE |  | SC1, SC2, SC3, SC4 | SC - KXOB22-04X3L | RS - RESISTOR VARIABLE | 4 | Digikey | KXOB22-04X3L-ND (https://octopart-clicks.com/click/altium?manufacturer=Supplier%20disabled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)
5003K |  | TP1, TP2, TP3, TP4, TP5, TP6, TP7, TP8 | TP - VERTICAL | TP - Test point vertical | 8 | Newark | 62W5140 (https://octopart-clicks.com/click/altium?sku=62W5140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)
