FredericChasse/Testbench_PCB/Solidworks/Parts.PNG

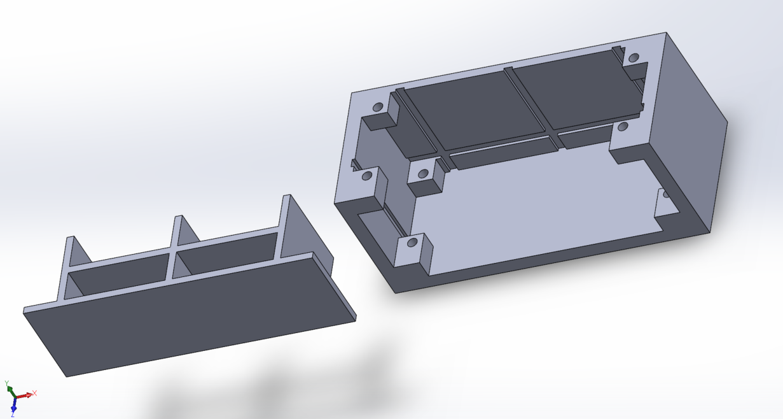
Solidworks/Parts.PNG
