FredericChasse/Testbench_PCB/Solidworks/Benchtest_assy.SLDASM

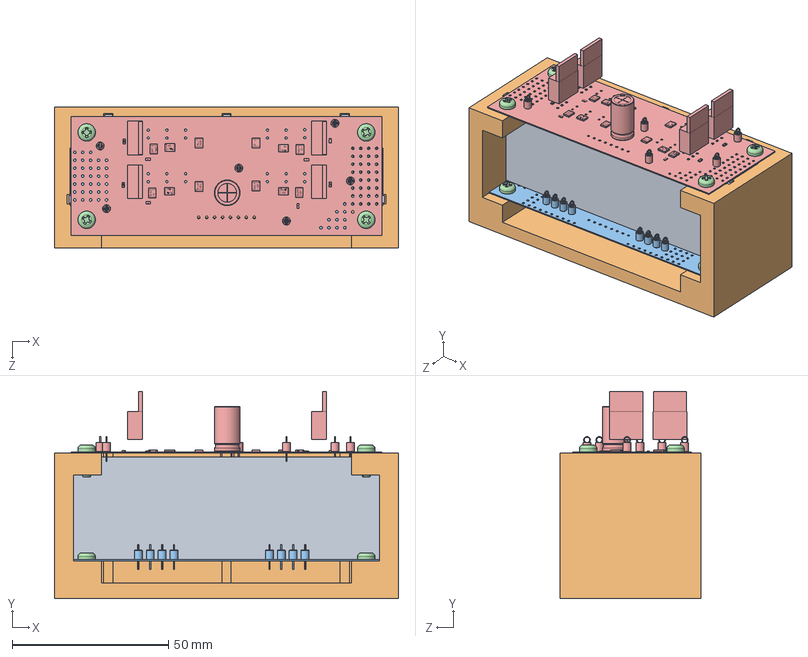
[picture p36: CAD file, 2017-02-09]
Solidworks/Benchtest_assy.SLDASM
110.0 x 66.2 x 45.0 mm
Separator
Benchtest - v1_0
Solar_board
PHT 3x8x7.5-type I-D-N x 8
LED_board
