FredericChasse/Testbench_PCB/parts/solar_cell.STEP

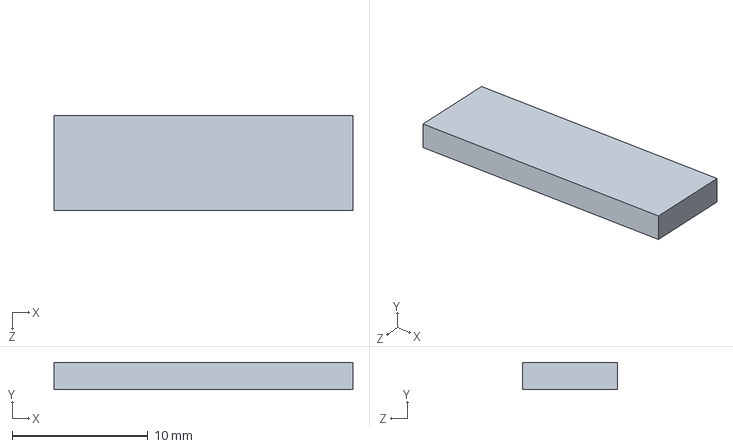
[picture p37: CAD file, 2017-02-09]
parts/solar_cell.STEP
22.0 x 2.00 x 7.00 mm
