FredericChasse/Testbench_PCB/solar_board/solar_board.step

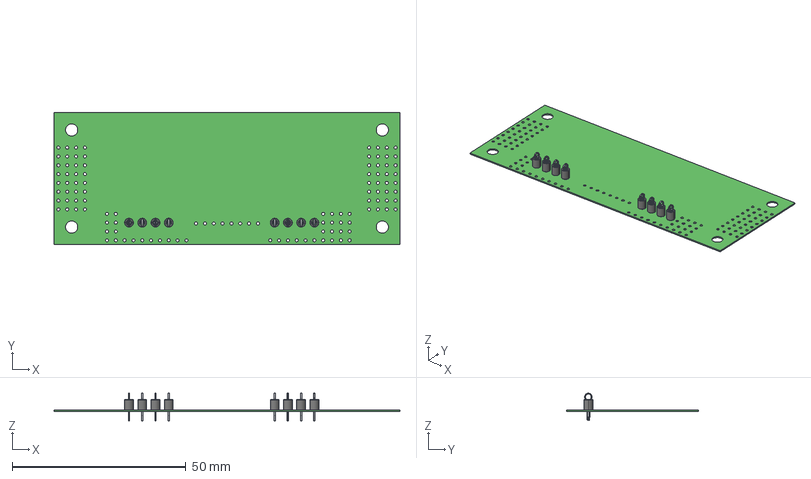
[picture p38: CAD file, 2017-02-09]
solar_board/solar_board.step
99.6 x 38.1 x 7.96 mm
Board
User_Library-TEST_POINT_BLK_Keystone_5001 x 8
