FredericChasse/Testbench_PCB/Solidworks/LED_board.SLDPRT

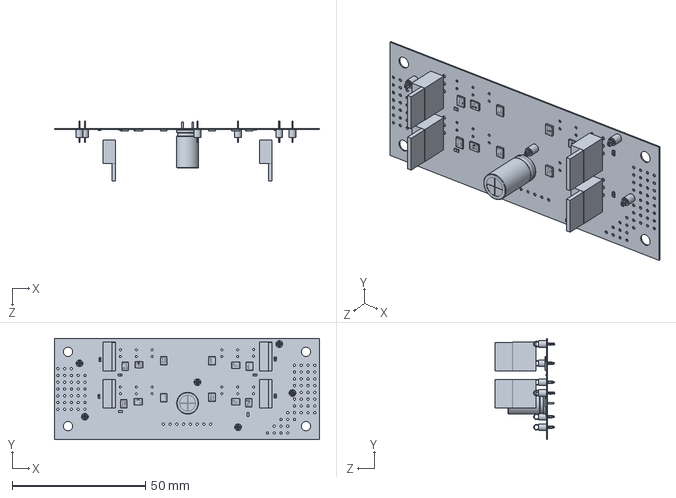
[picture p39: CAD file, 2017-02-09]
Solidworks/LED_board.SLDPRT
99.6 x 38.1 x 22.4 mm
