FredericChasse/Testbench_PCB/parts/pj-002ah.stp

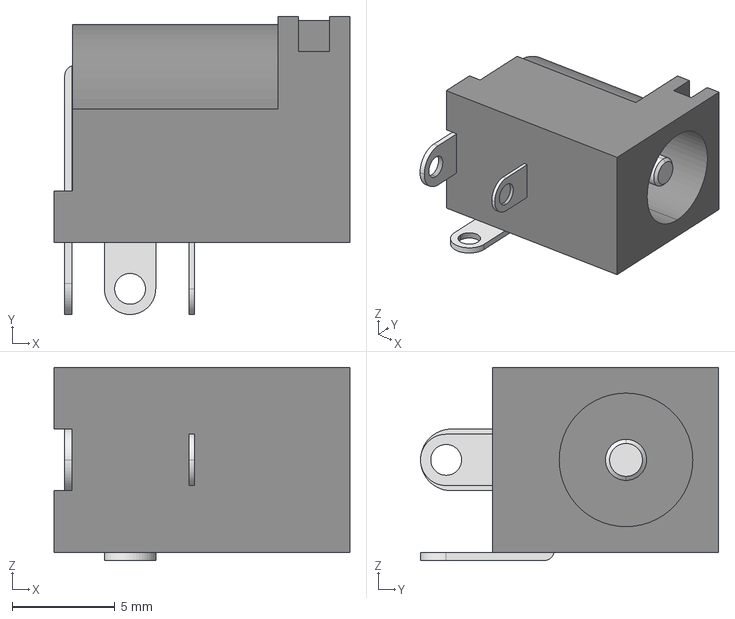
[picture p40: CAD file, 2017-02-09]
parts/pj-002ah.stp
14.4 x 14.5 x 9.40 mm
