FredericChasse/Testbench_PCB/solar_board/top_level_solar_cells.step

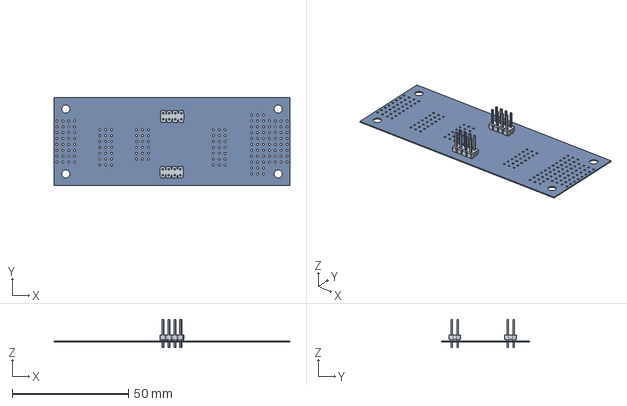
[picture p41: CAD file, 2017-02-09]
solar_board/top_level_solar_cells.step
101.6 x 38.1 x 12.2 mm
Board
CON___-_HEADER_MALE_2X4PINS x 34
