FredericChasse/Testbench_PCB/Solidworks/Base_part.STL

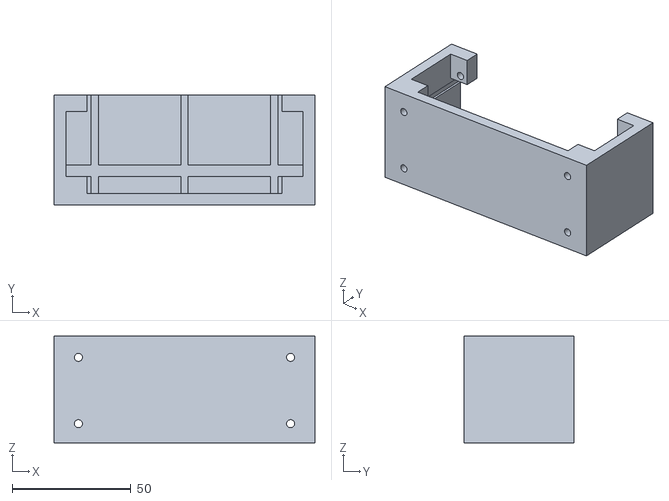
[picture p42: CAD file, 2017-02-09]
Solidworks/Base_part.STL
110.0 x 46.5 x 45.0
