FredericChasse/Testbench_PCB/Solidworks/Base_part_v2.STL

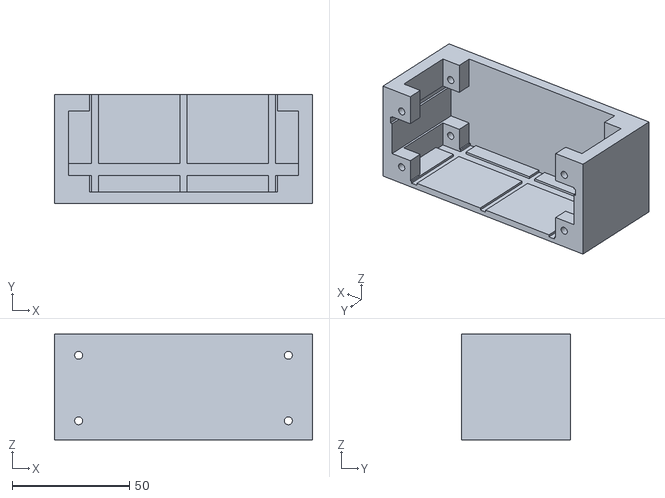
[picture p43: CAD file, 2017-02-09]
Solidworks/Base_part_v2.STL
110.0 x 46.5 x 45.0
