FredericChasse/Testbench_PCB/Solidworks/Solar_board.step

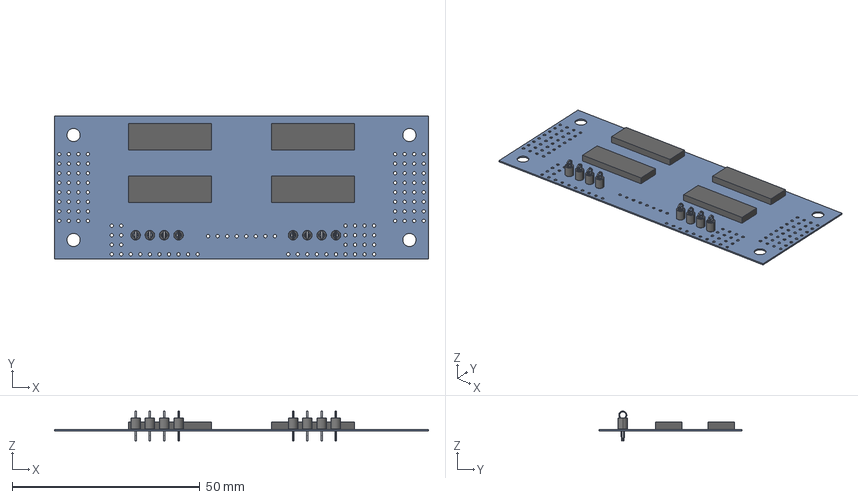
[picture p44: CAD file, 2017-02-09]
Solidworks/Solar_board.step
99.6 x 38.1 x 7.96 mm
Board
solar_cell x 4
User_Library-TEST_POINT_BLK_Keystone_5001 x 8
