FredericChasse/Testbench_PCB/Solidworks/Slide_in_part.STL

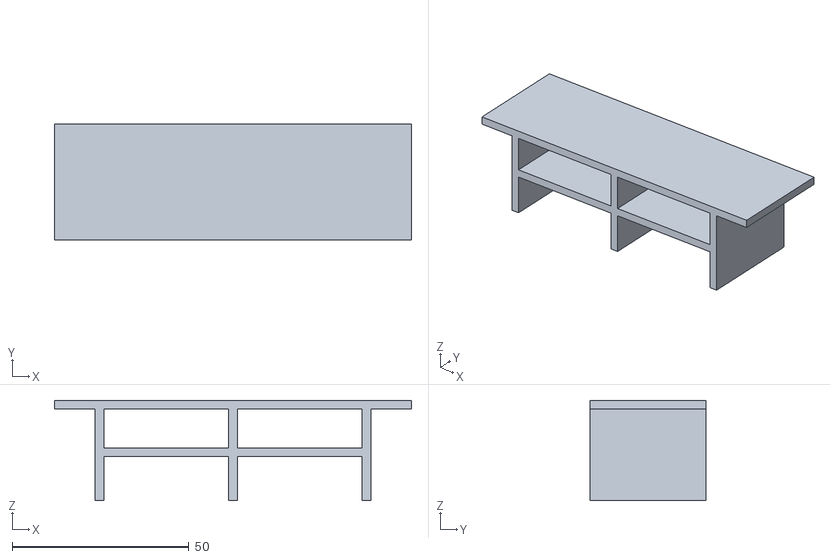
[picture p45: CAD file, 2017-02-09]
Solidworks/Slide_in_part.STL
101.0 x 32.9 x 28.3
