FredericChasse/Testbench_PCB/Solidworks/vertical_panel.SLDPRT

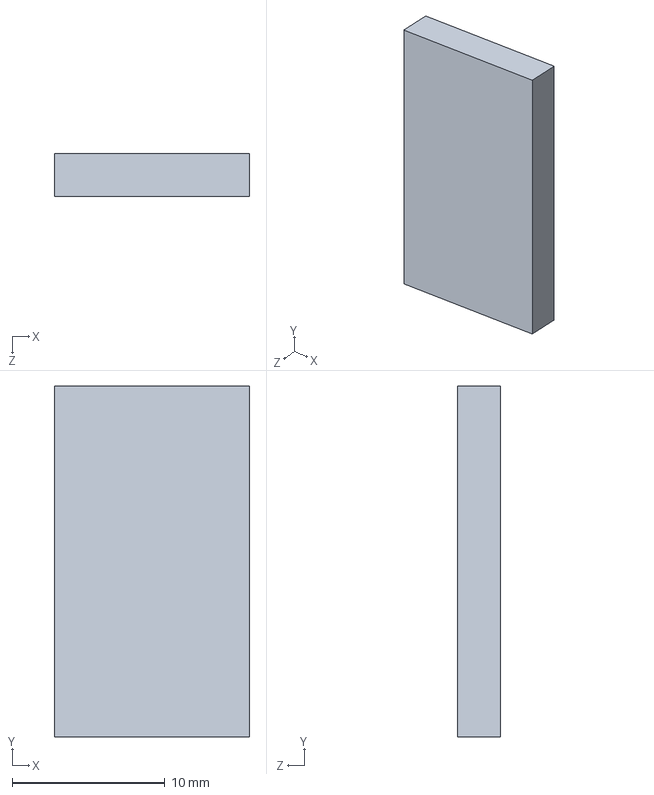
[picture p46: CAD file, 2017-02-09]
Solidworks/vertical_panel.SLDPRT
12.8 x 23.0 x 2.80 mm
