FredericChasse/Testbench_PCB/Solidworks/Horizontal_panel.SLDPRT

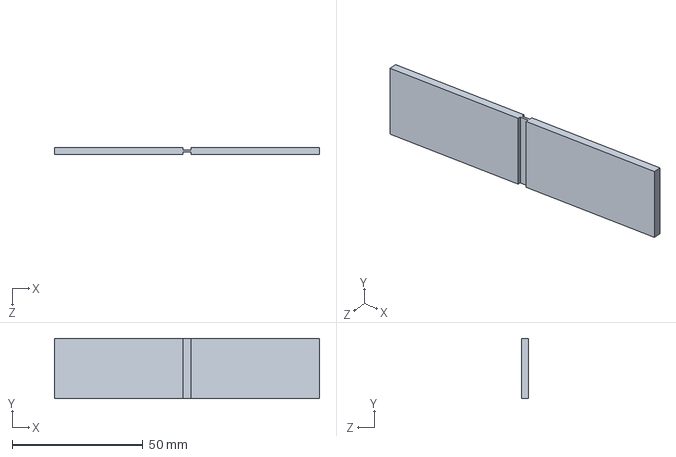
[picture p47: CAD file, 2017-02-09]
Solidworks/Horizontal_panel.SLDPRT
101.5 x 23.0 x 2.80 mm
