FredericChasse/Testbench_PCB/(list of files, cad)

Other CAD files:
Solidworks/Separator.SLDPRT
Solidworks/Benchtest - v1_0.SLDPRT
Solidworks/Solar_board.SLDPRT
parts/solar_cell.SLDPRT
