FredericChasse/Testbench_PCB/Solidworks/Montage complet.PNG

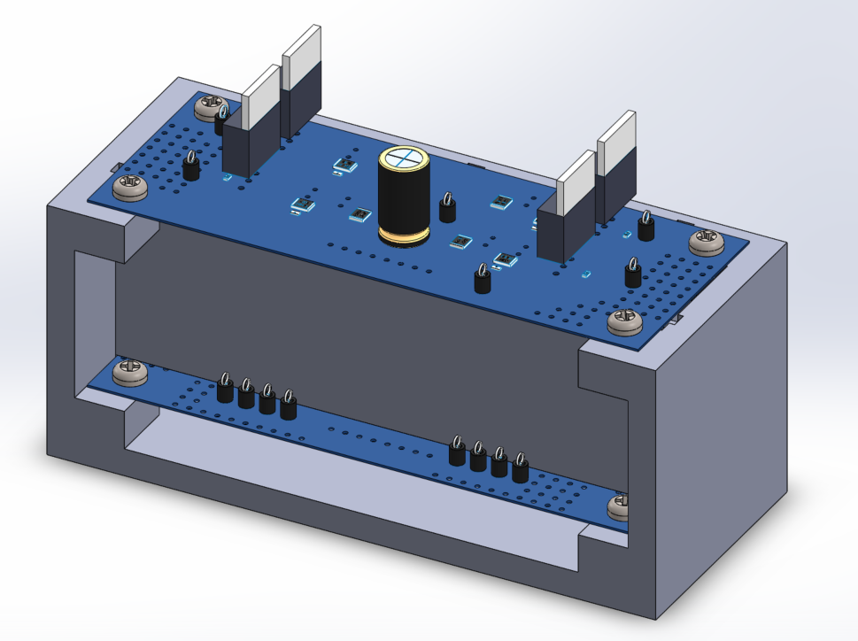
Solidworks/Montage complet.PNG
