FredericChasse/Testbench_PCB/MATLAB/4cells/test.jpg

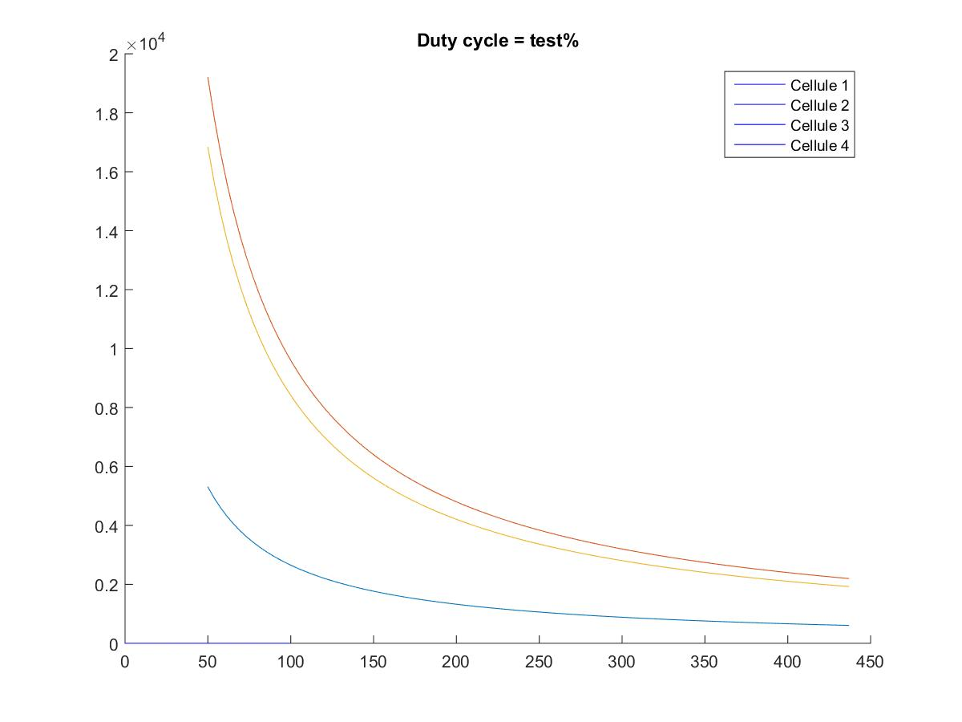
MATLAB/4cells/test.jpg
