FredericChasse/Testbench_PCB/MATLAB/Multi-Unit/FirstResults.PNG

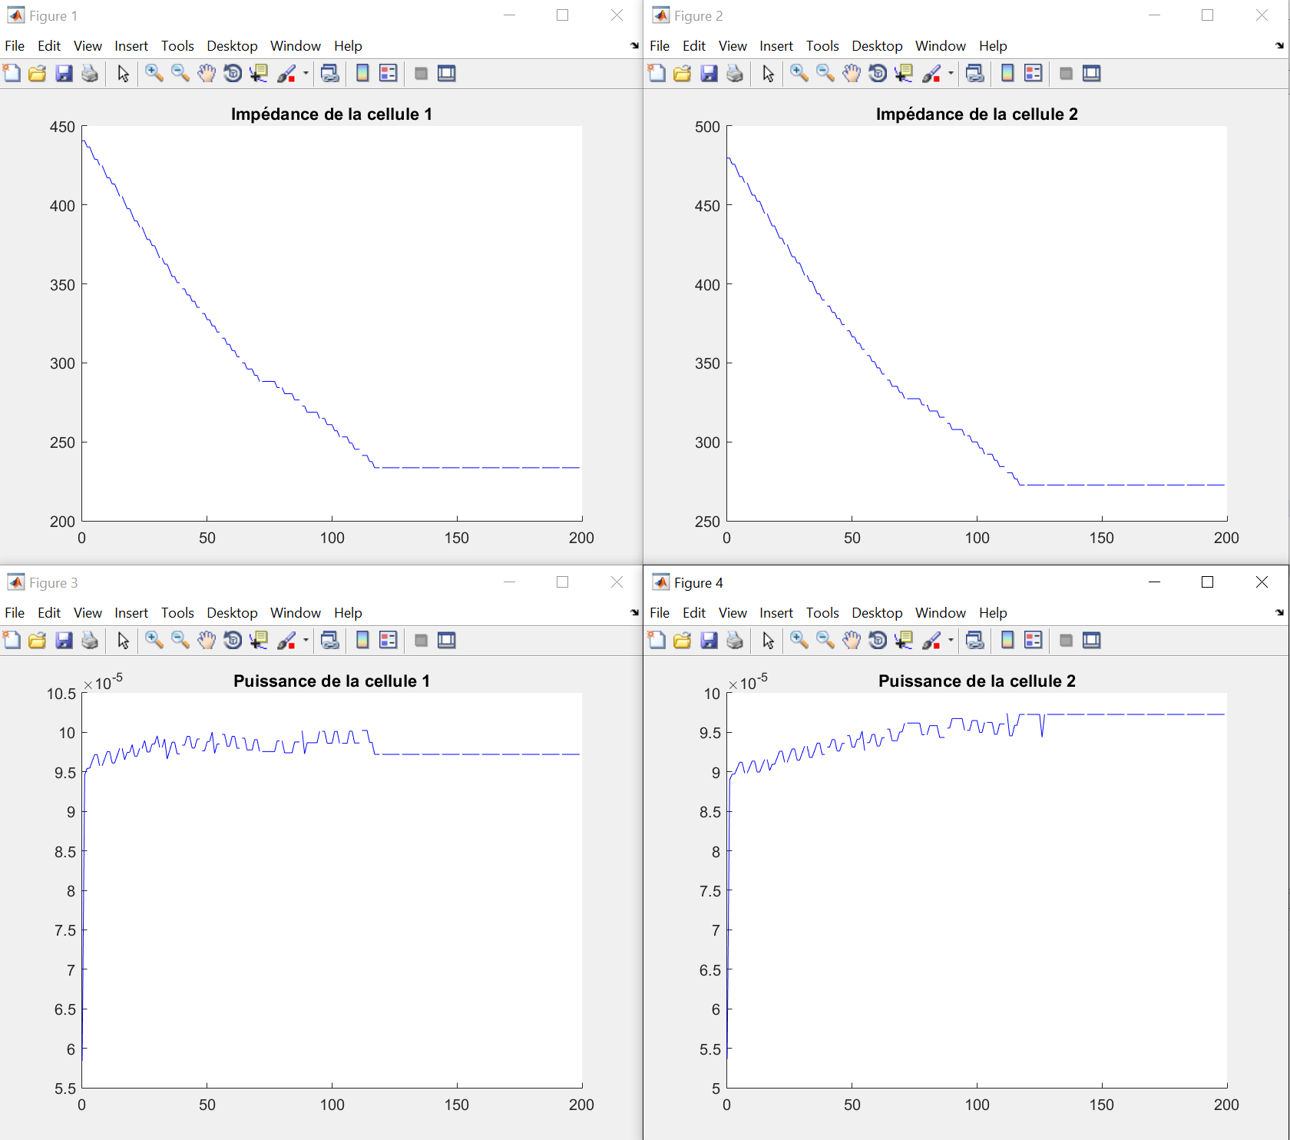
MATLAB/Multi-Unit/FirstResults.PNG
