FredericChasse/Testbench_PCB/Photos/Testbench_complet.jpg

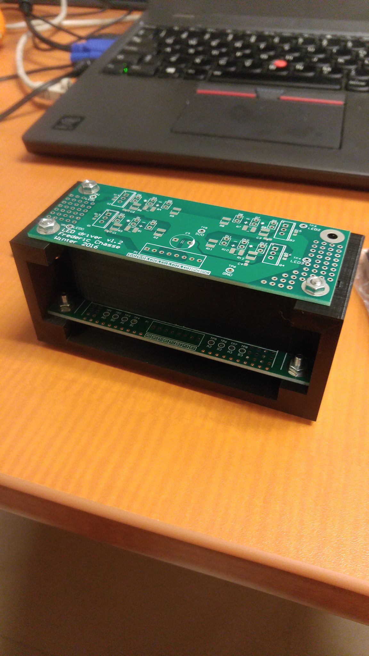
Photos/Testbench_complet.jpg
