FredericChasse/Testbench_PCB/Tests/courbe_2_led/dc10.jpg

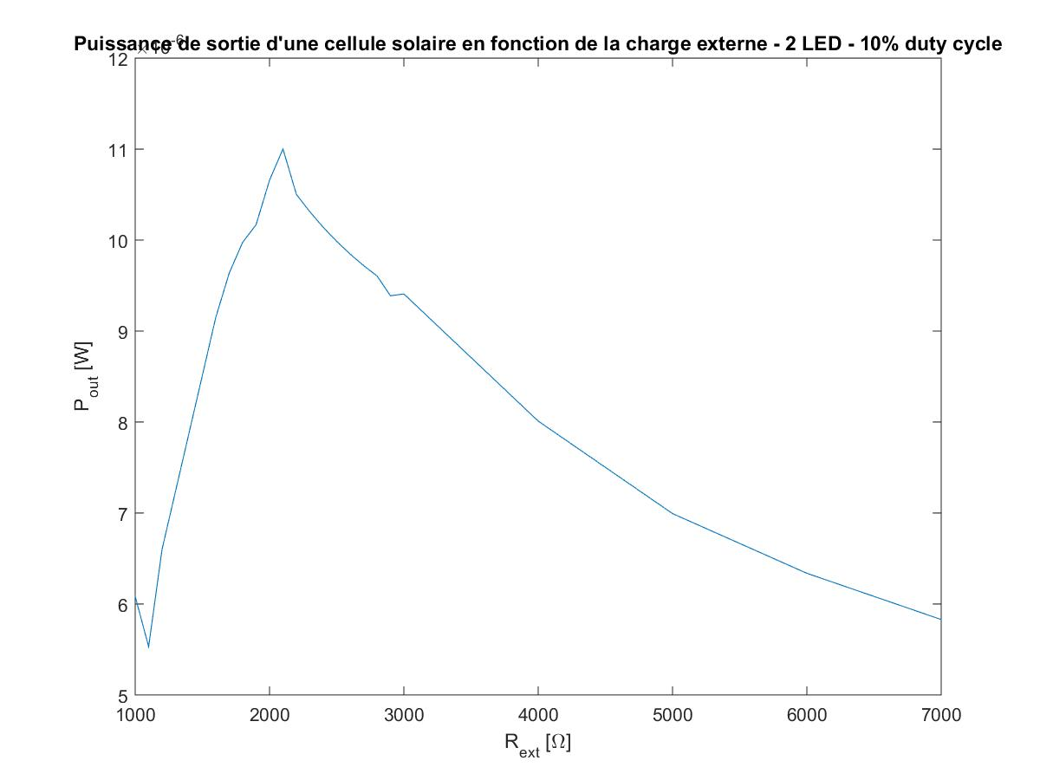
Tests/courbe_2_led/dc10.jpg
