FredericChasse/Testbench_PCB/Tests/courbe_2_led/dc30.jpg

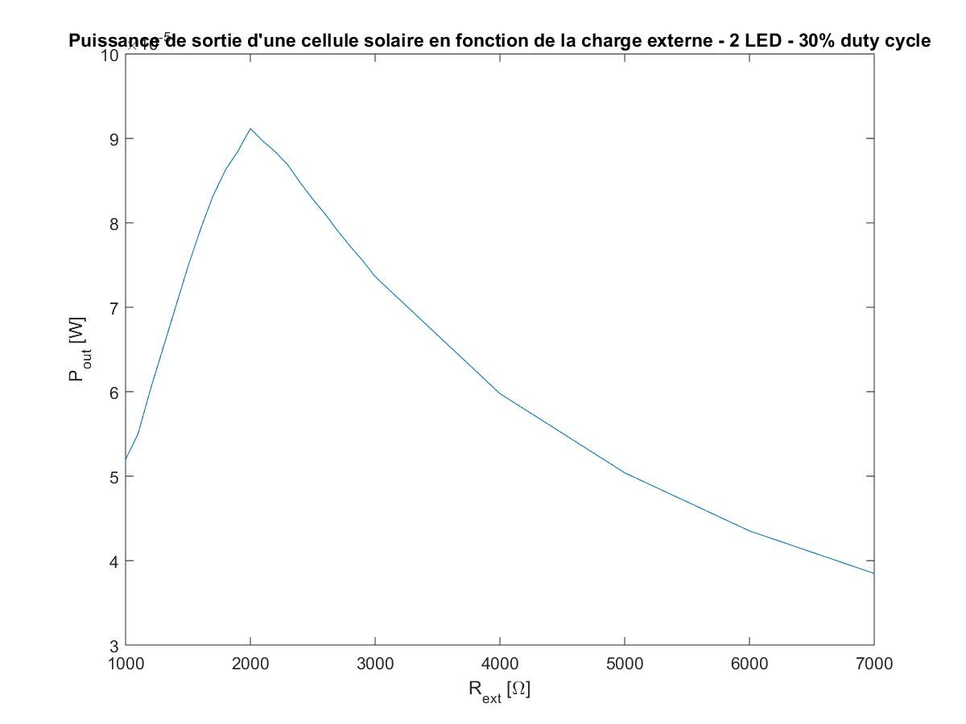
Tests/courbe_2_led/dc30.jpg
