FredericChasse/Testbench_PCB/Tests/courbe_2_led/dc50.jpg

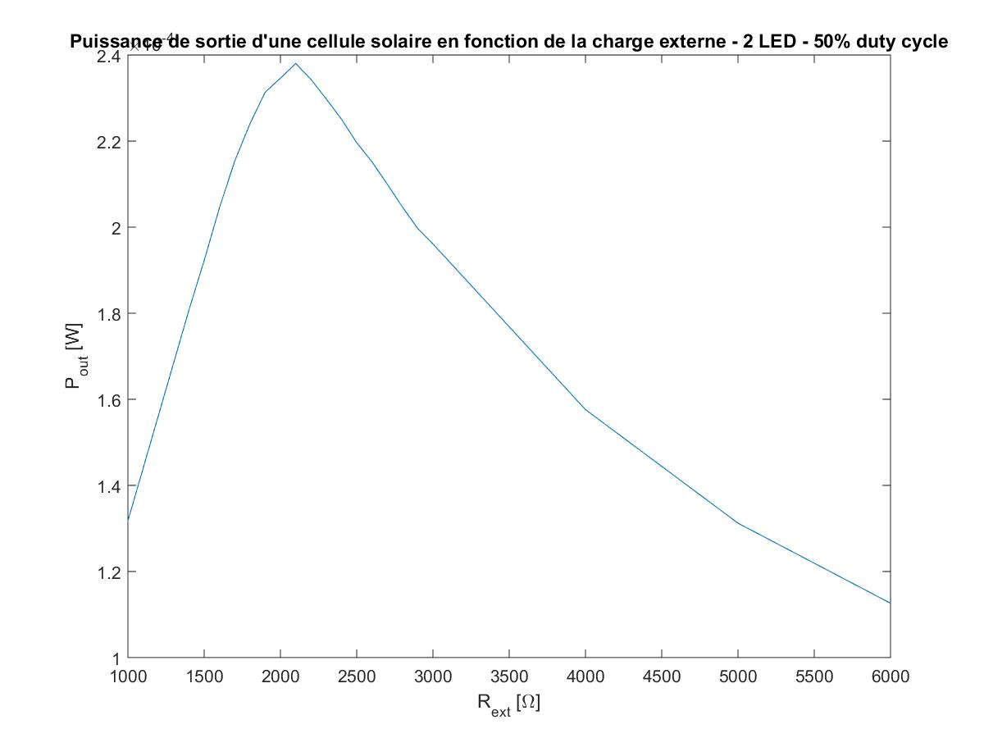
Tests/courbe_2_led/dc50.jpg
