FredericChasse/Testbench_PCB/Tests/courbe_3_led/dc0_1.jpg

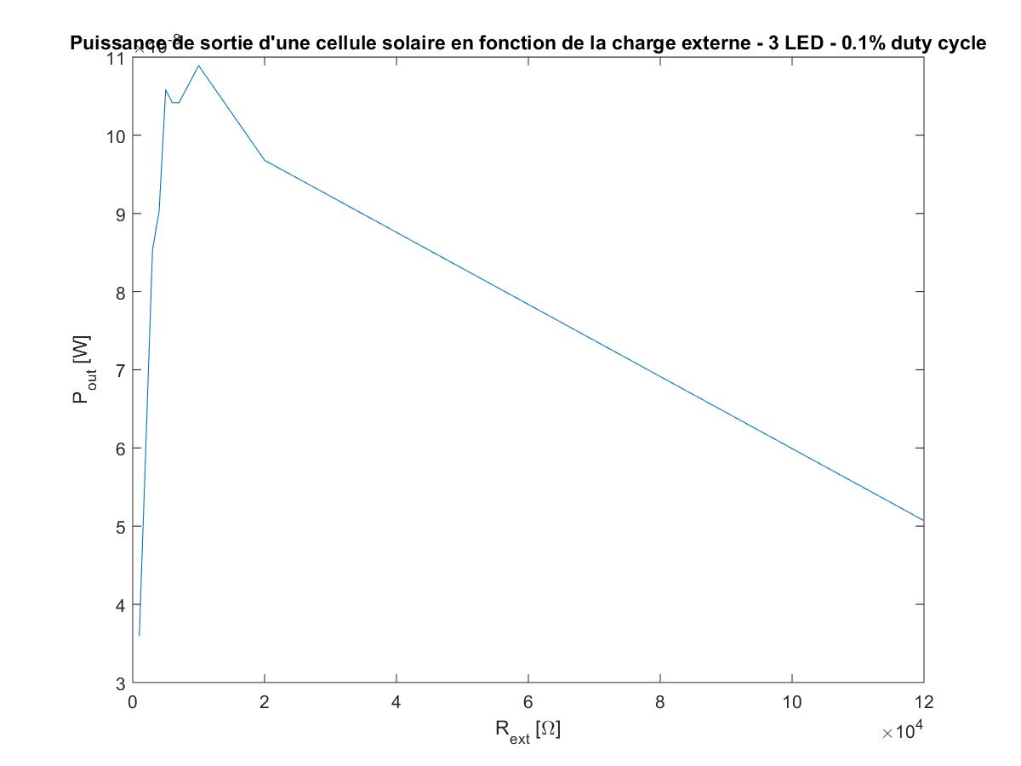
Tests/courbe_3_led/dc0_1.jpg
