FredericChasse/Testbench_PCB/Tests/courbe_3_led/dc1.jpg

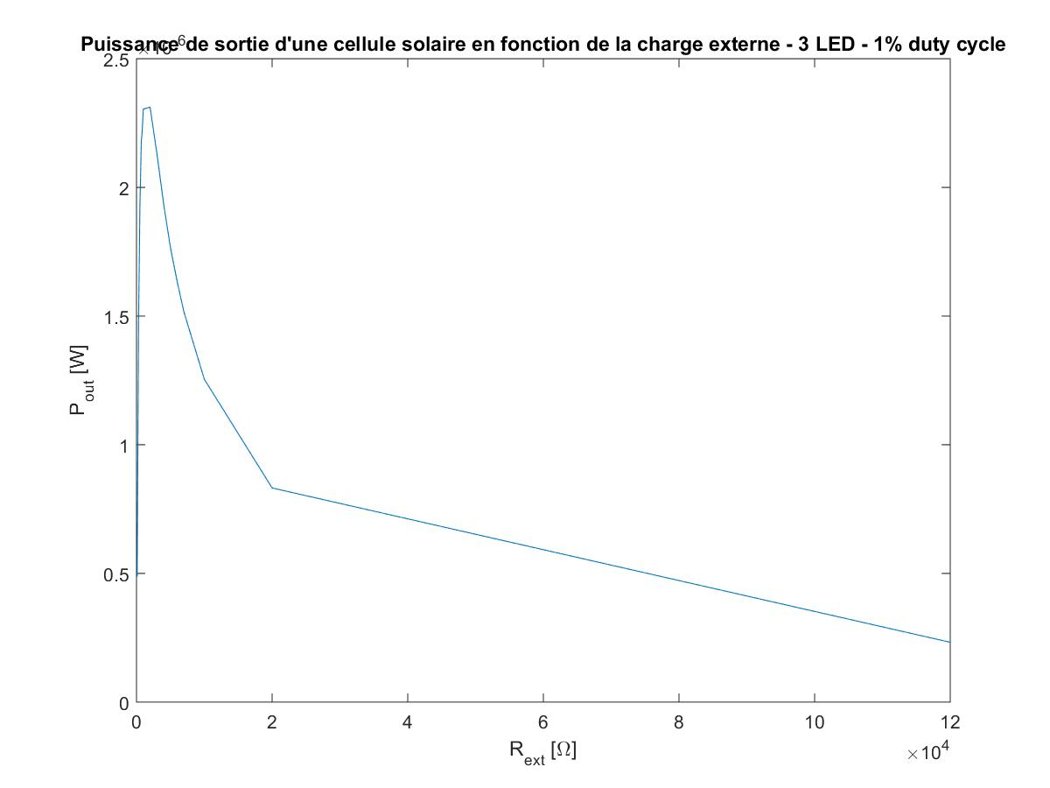
Tests/courbe_3_led/dc1.jpg
