FredericChasse/Testbench_PCB/Tests/courbe_3_led/dc3.jpg

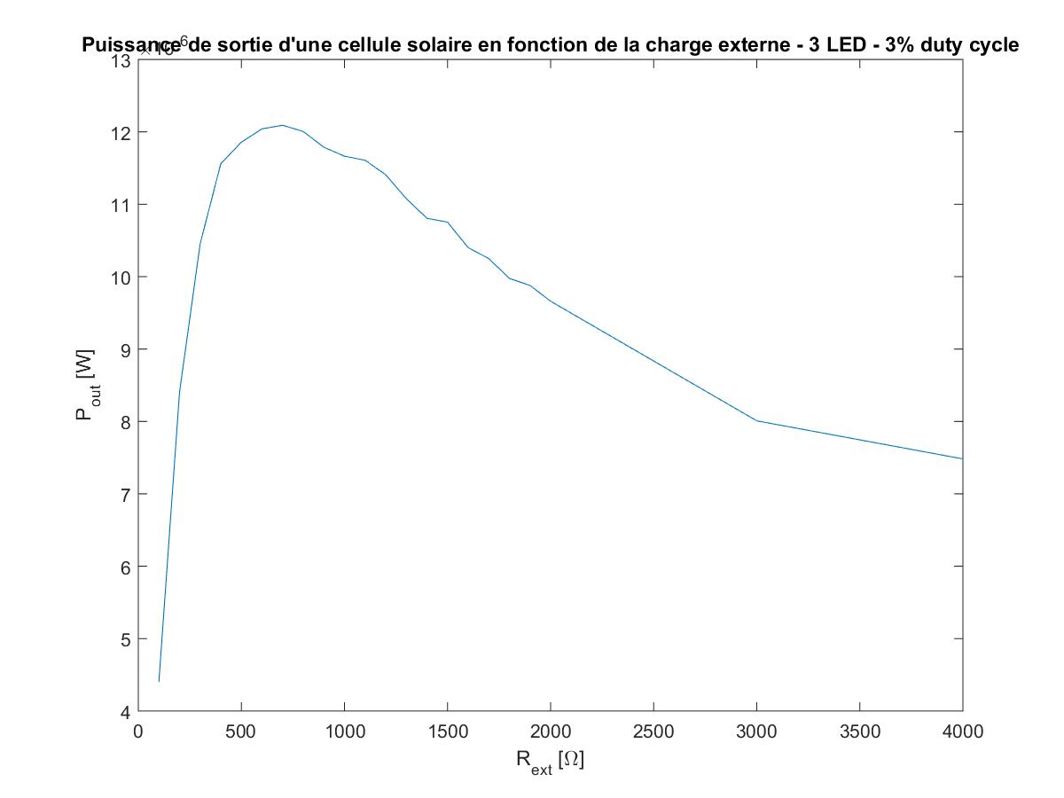
Tests/courbe_3_led/dc3.jpg
