FredericChasse/Testbench_PCB/Tests/courbe_3_led/dc4.jpg

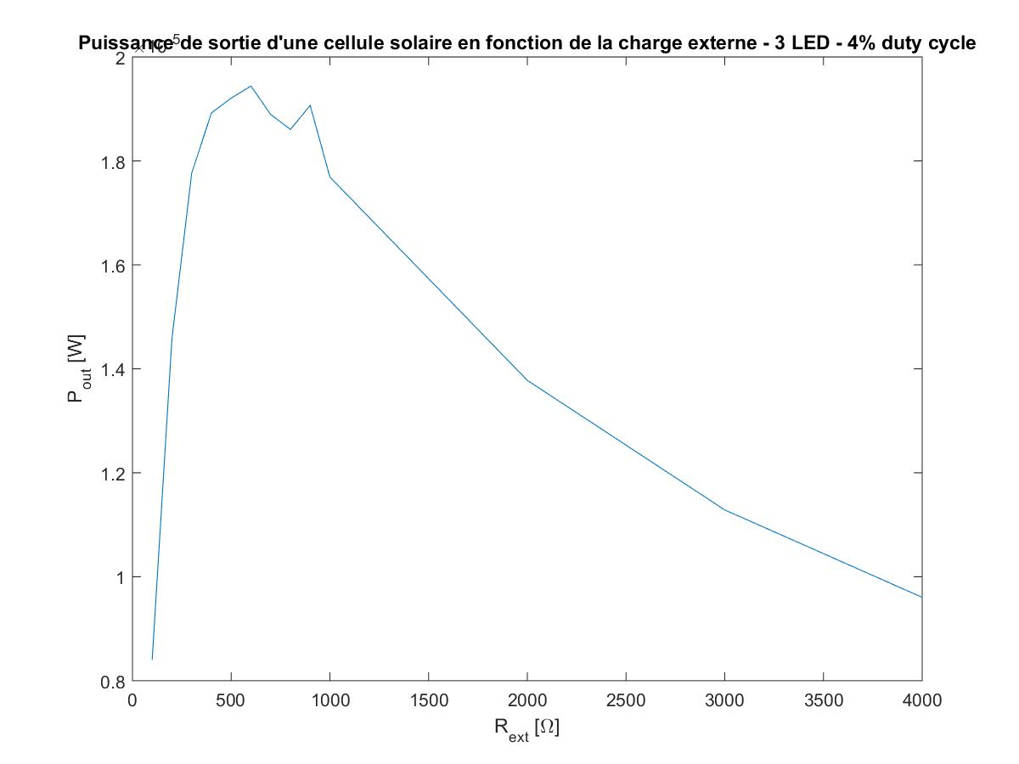
Tests/courbe_3_led/dc4.jpg
