FredericChasse/Testbench_PCB/Tests/courbe_3_led/dc5.jpg

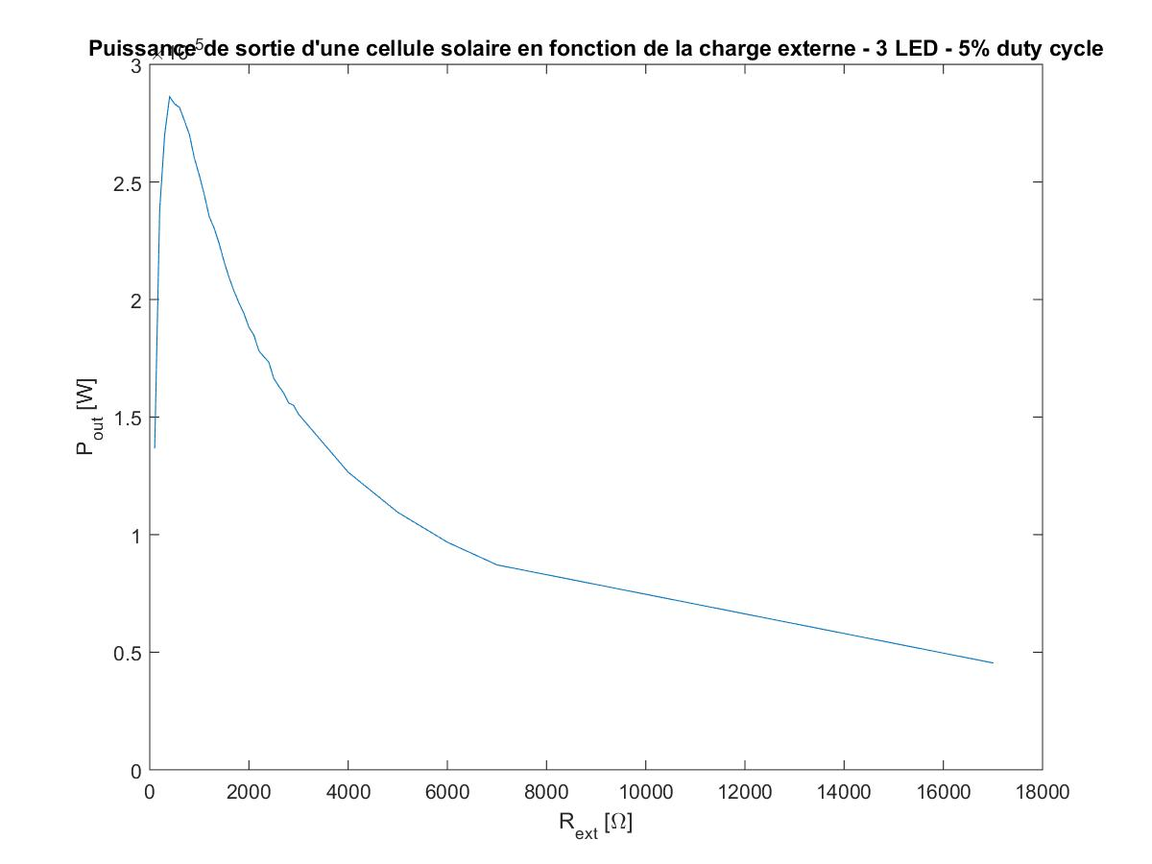
Tests/courbe_3_led/dc5.jpg
