FredericChasse/Testbench_PCB/Tests/courbe_3_led/dc10.jpg

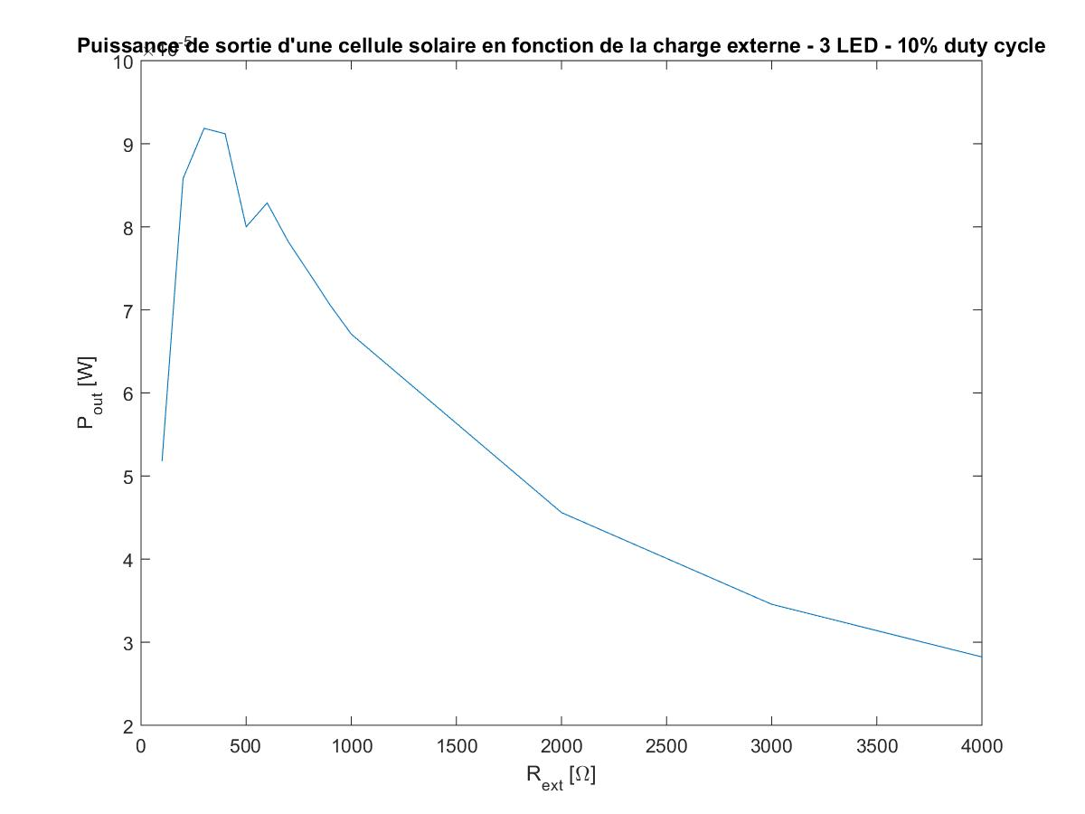
Tests/courbe_3_led/dc10.jpg
