FredericChasse/Testbench_PCB/Tests/courbe_3_led/dc20.jpg

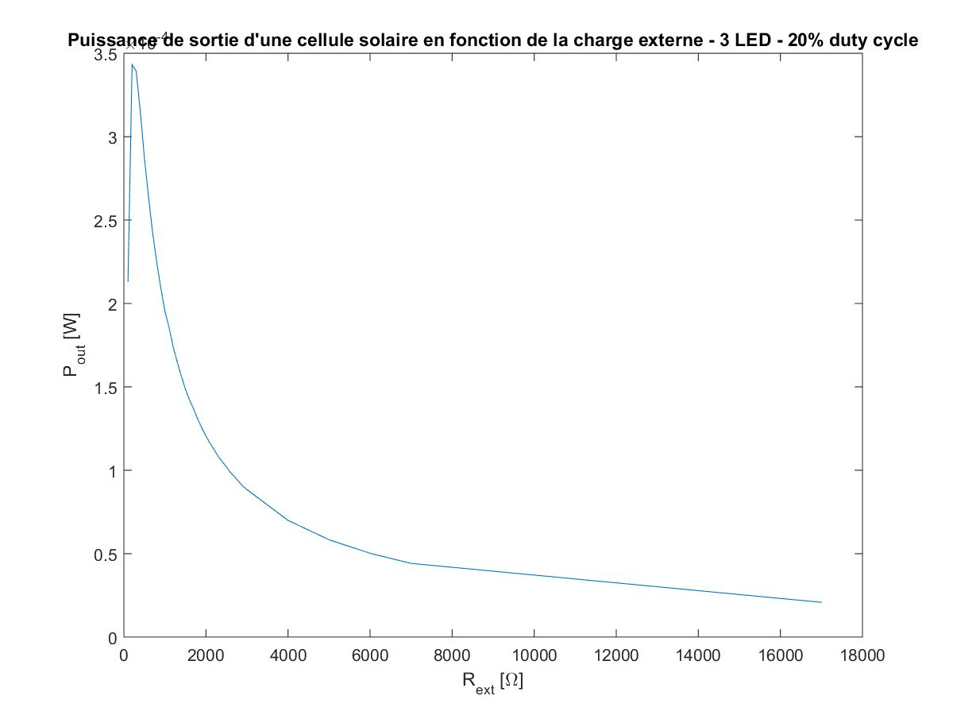
Tests/courbe_3_led/dc20.jpg
