FredericChasse/Testbench_PCB/Tests/courbe_3_led/dc50.jpg

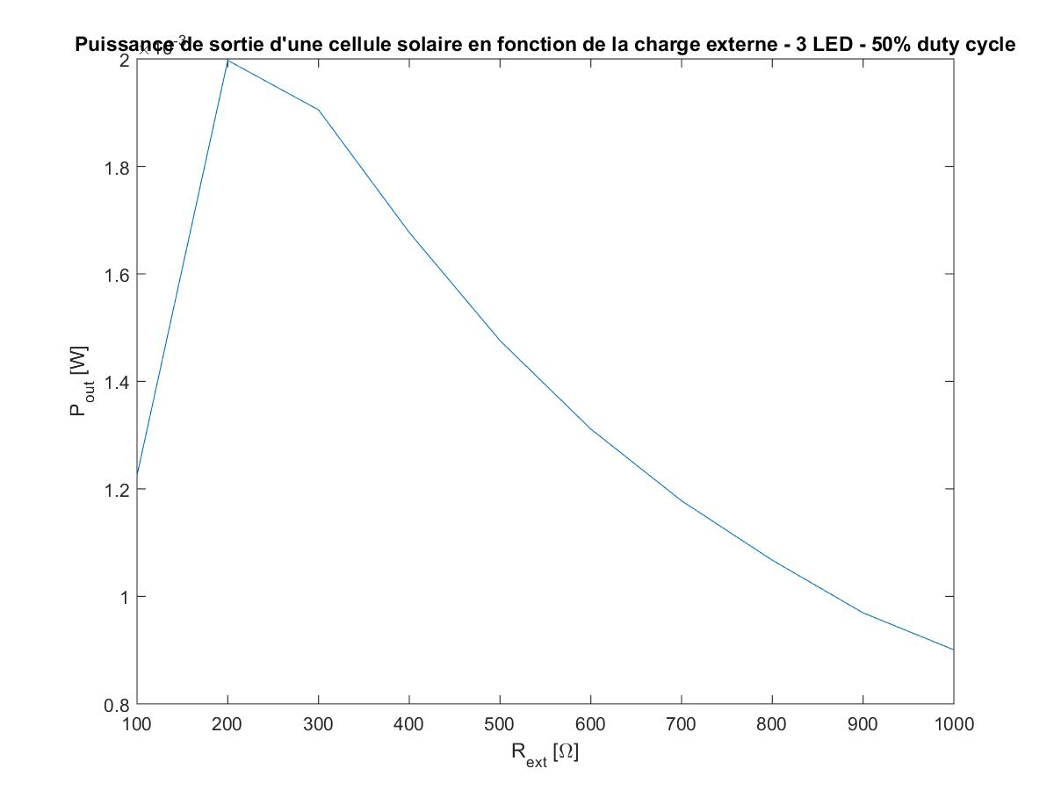
Tests/courbe_3_led/dc50.jpg
