FredericChasse/Testbench_PCB/Tests/Courbe_puissance_avec_trois_LEDs/Faible_luminosité.jpg

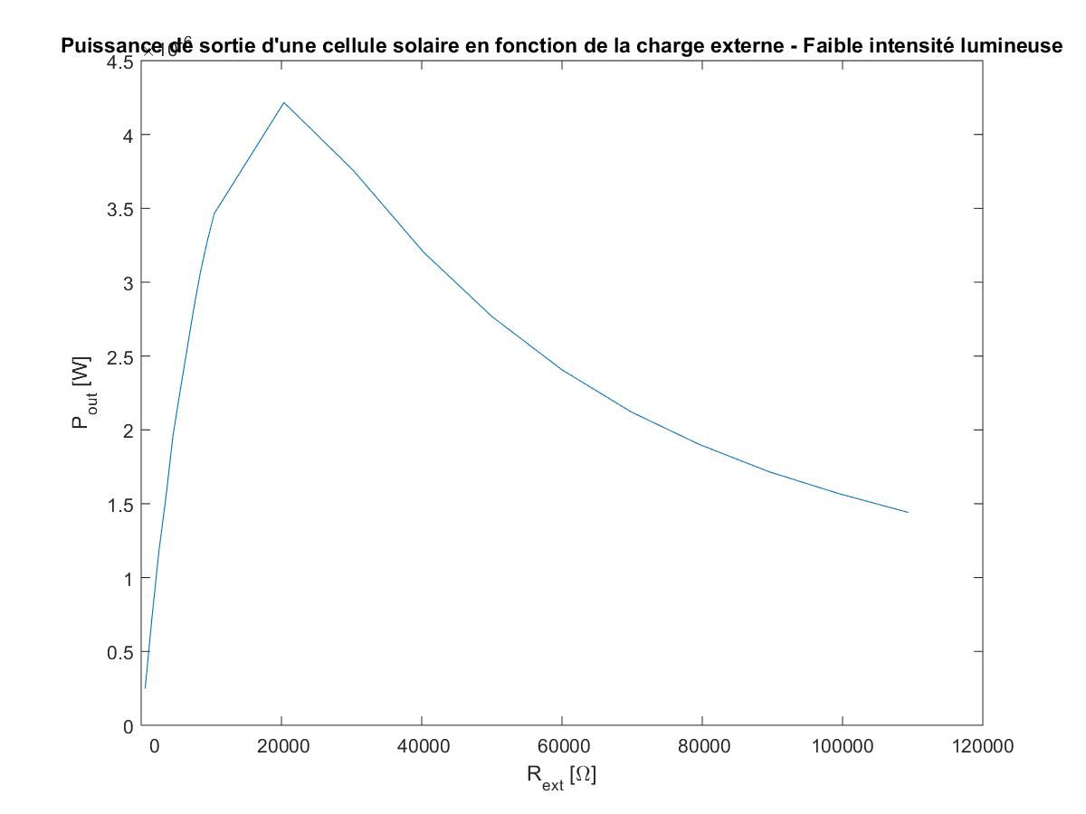
Tests/Courbe_puissance_avec_trois_LEDs/Faible_luminosité.jpg
