FredericChasse/Testbench_PCB/Tests/Courbe_puissance_avec_une_LED/Faible_luminosité.jpg

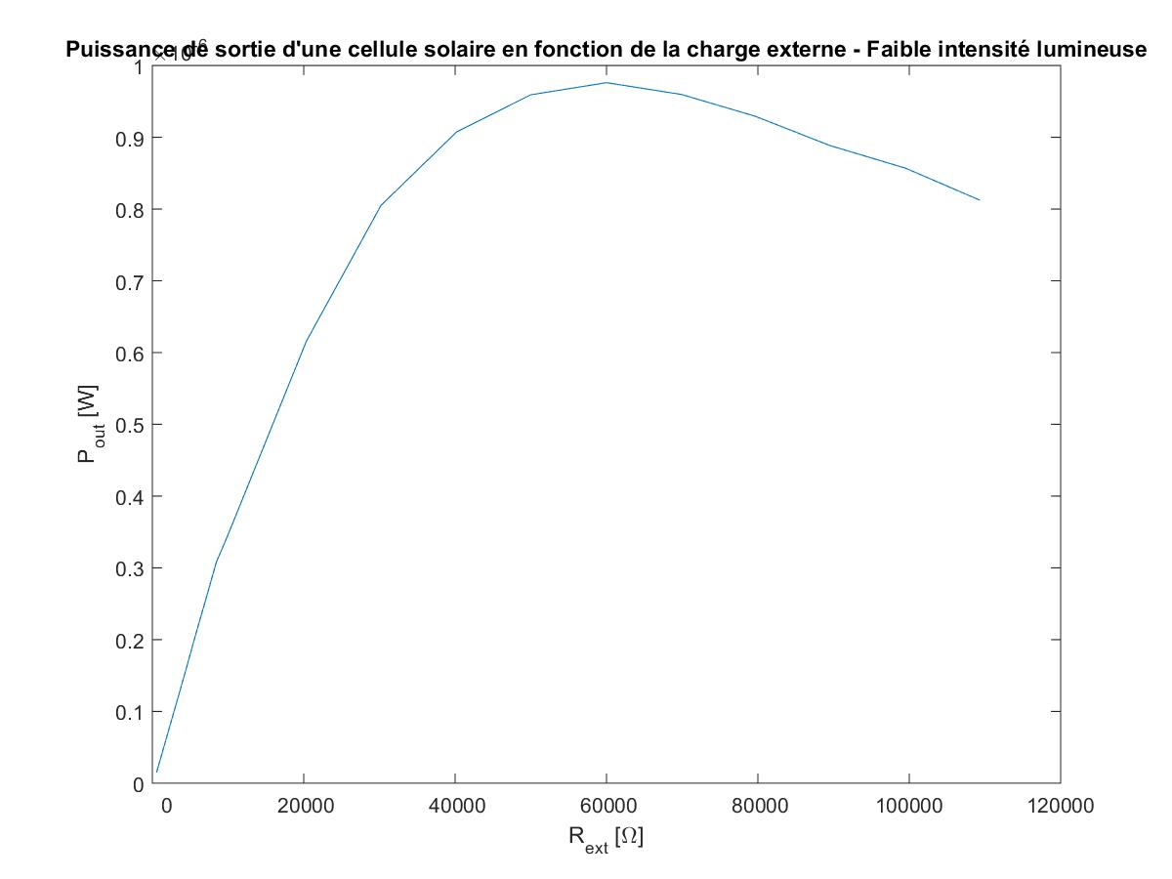
Tests/Courbe_puissance_avec_une_LED/Faible_luminosité.jpg
