FredericChasse/Testbench_PCB/Tests/Courbe_puissance_avec_une_LED/Moyenne_luminosité.jpg

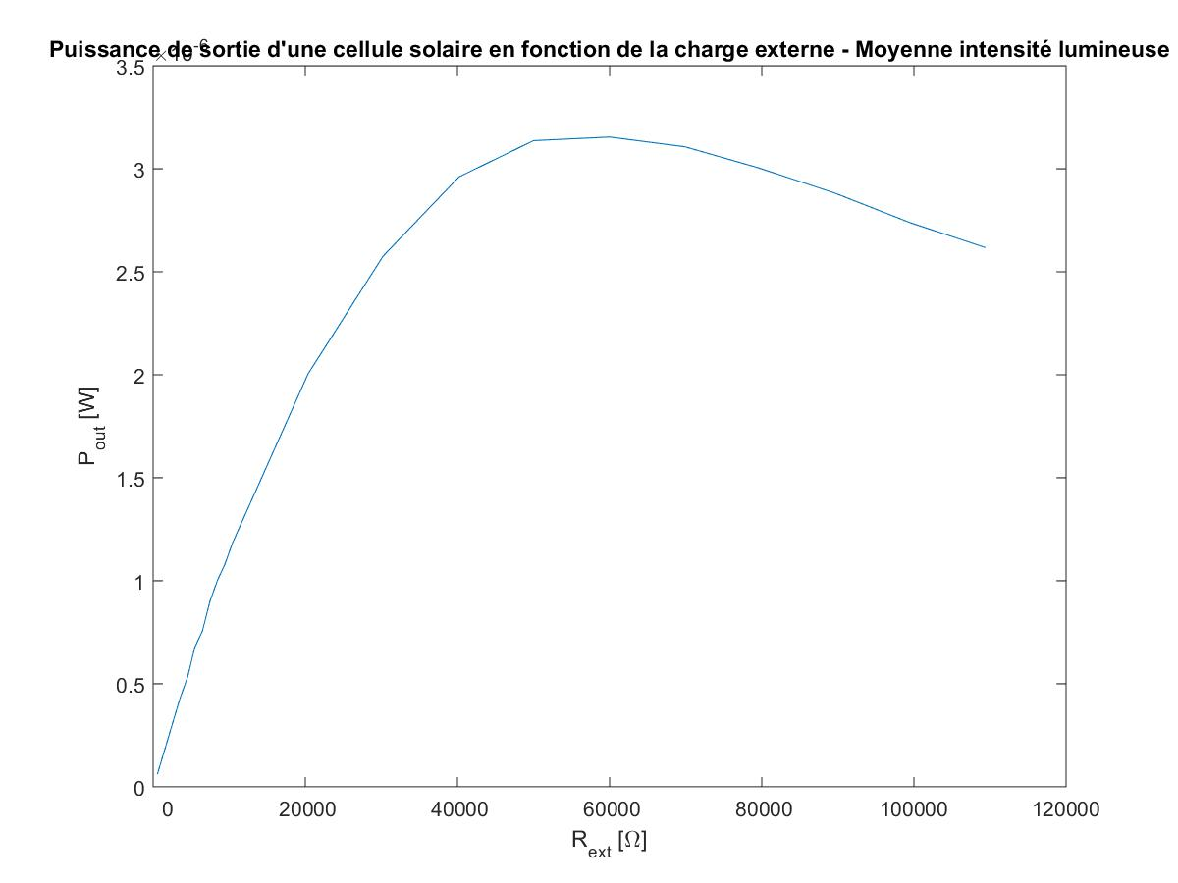
Tests/Courbe_puissance_avec_une_LED/Moyenne_luminosité.jpg
