FredericChasse/Testbench_PCB/Tests/Courbe_puissance_avec_une_LED_bon_MOSFET/Faible_luminosité.jpg

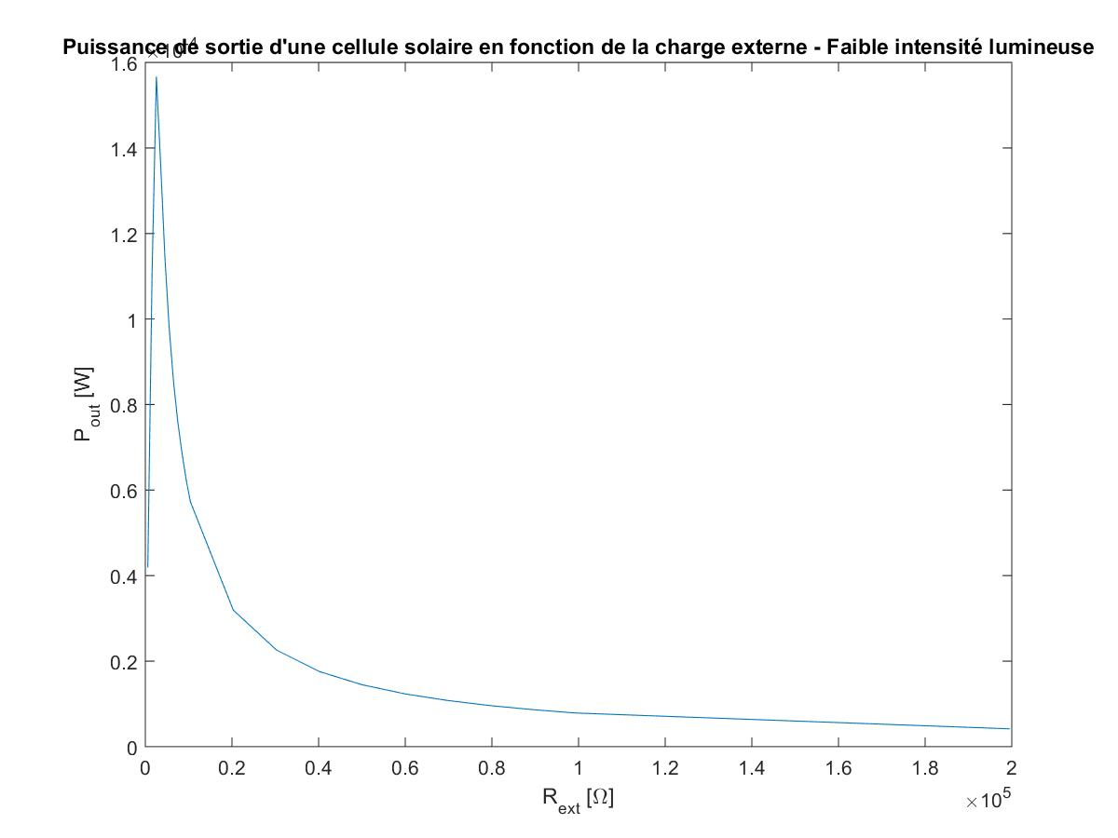
Tests/Courbe_puissance_avec_une_LED_bon_MOSFET/Faible_luminosité.jpg
