FredericChasse/Testbench_PCB/Tests/Courbe_puissance_premiere_cellule/Deux_luminosités.jpg

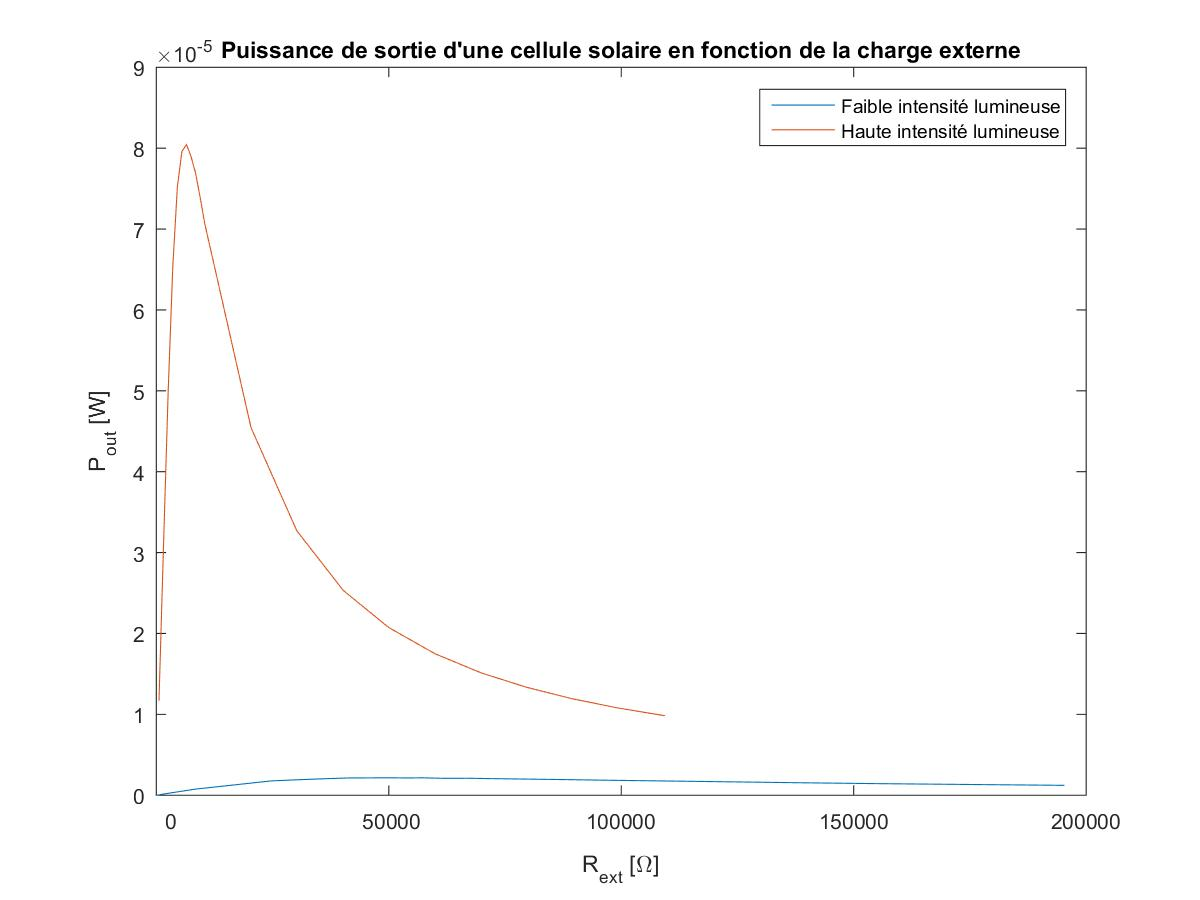
Tests/Courbe_puissance_premiere_cellule/Deux_luminosités.jpg
