FredericChasse/Testbench_PCB/Tests/Courbe_puissance_premiere_cellule/Faible_luminosité.jpg

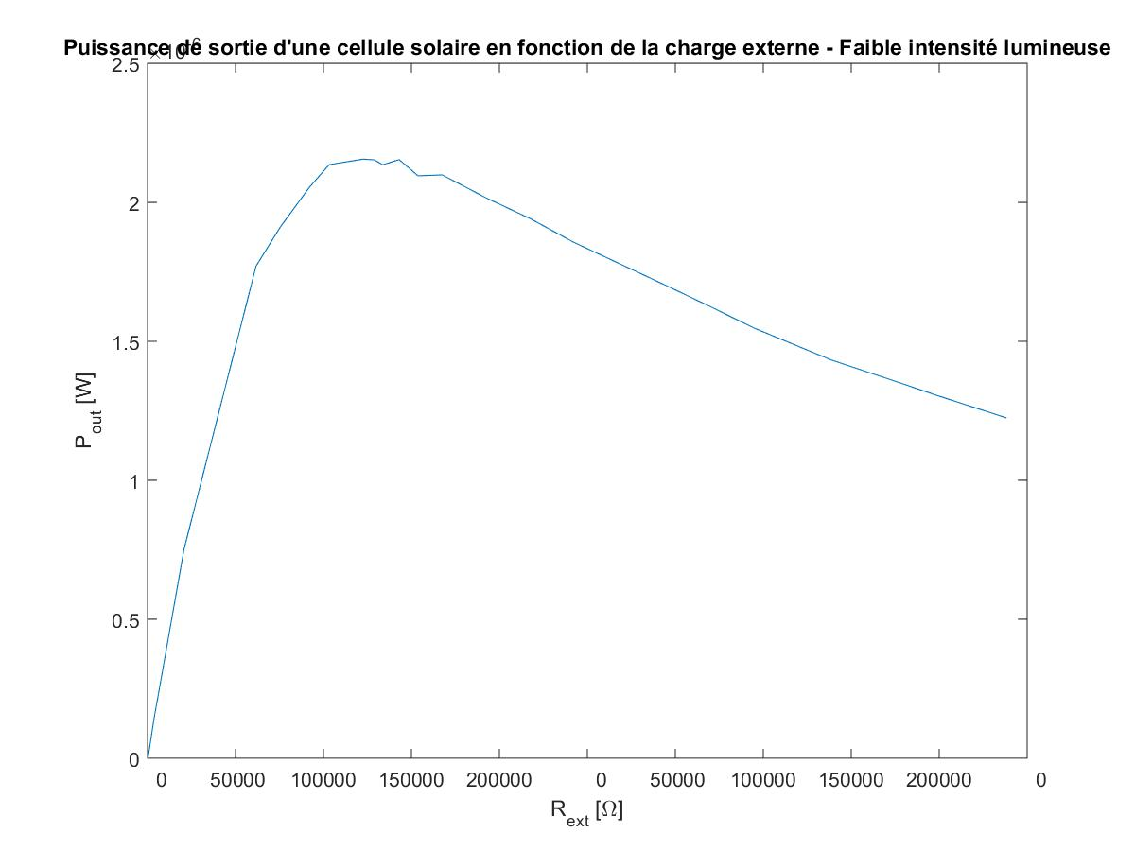
Tests/Courbe_puissance_premiere_cellule/Faible_luminosité.jpg
