FredericChasse/Testbench_PCB/Tests/Courbe_puissance_premiere_cellule/Haute_luminosité.jpg

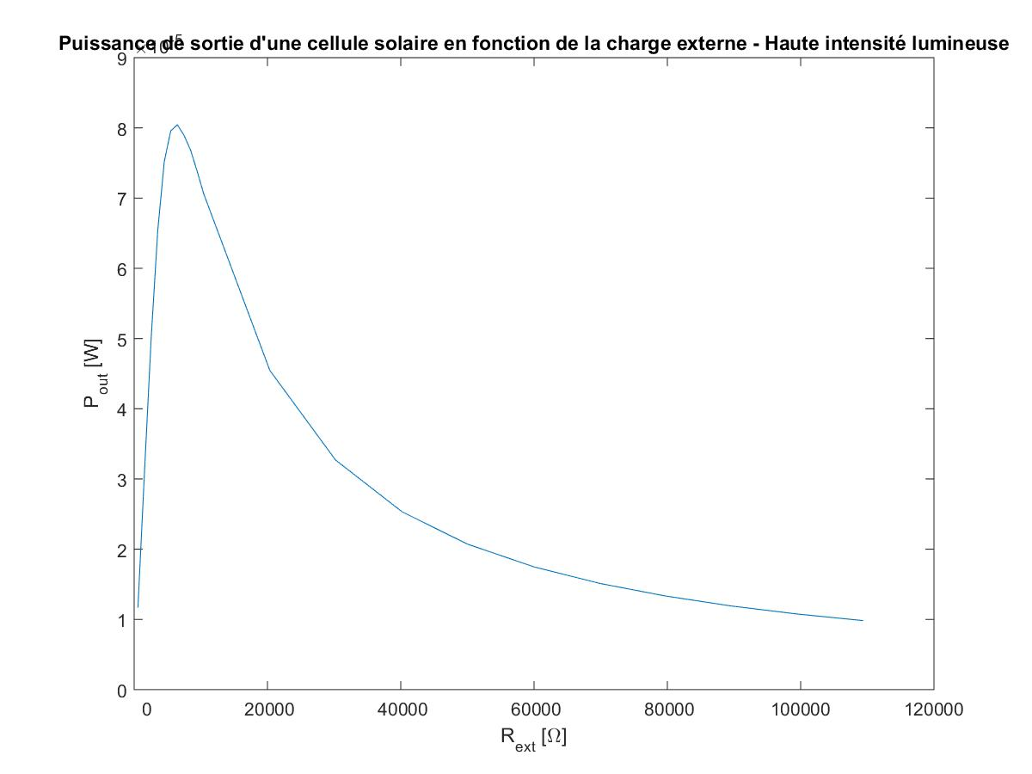
Tests/Courbe_puissance_premiere_cellule/Haute_luminosité.jpg
