FredericChasse/Testbench_PCB/Tests/Courbe_puissance_premiere_cellule/Moyenne_luminosité.jpg

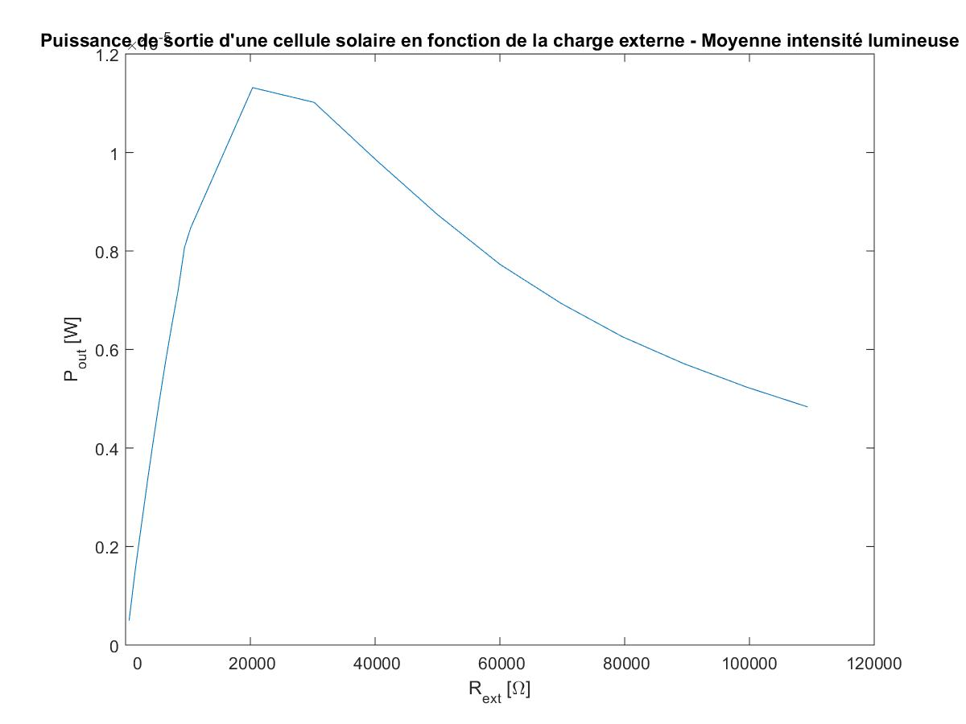
Tests/Courbe_puissance_premiere_cellule/Moyenne_luminosité.jpg
