FredericChasse/Testbench_PCB/ControlBoardSchematics.PDF

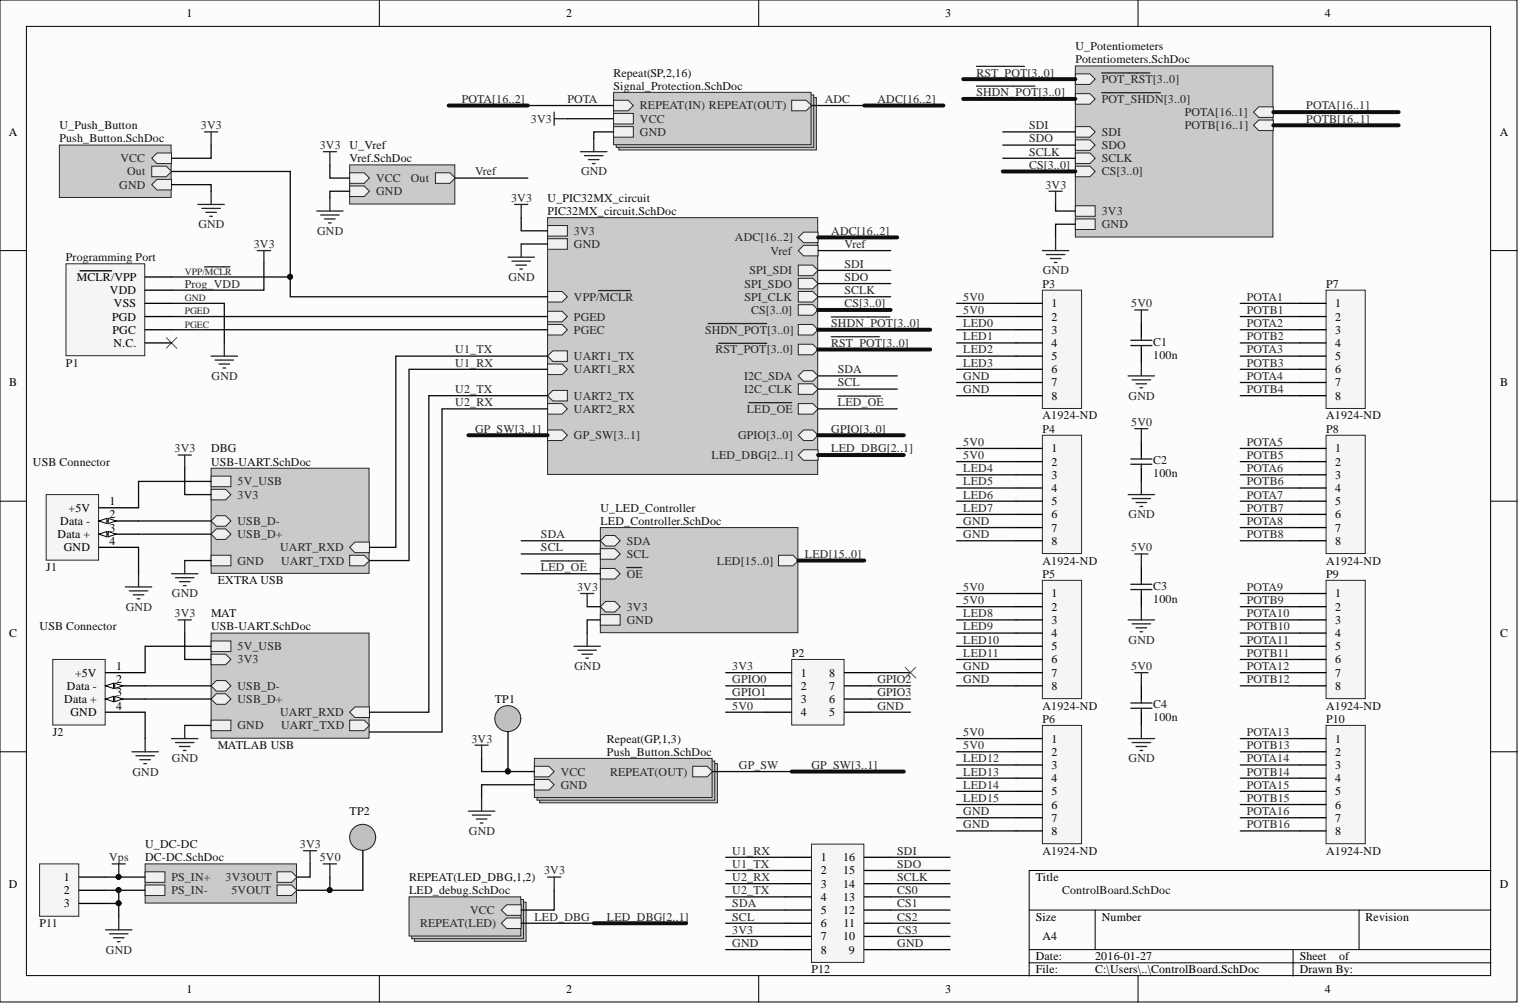
[picture p72: page 1]

Pro
D MCLR/VPP VDD VSS

GND PGED PGEC

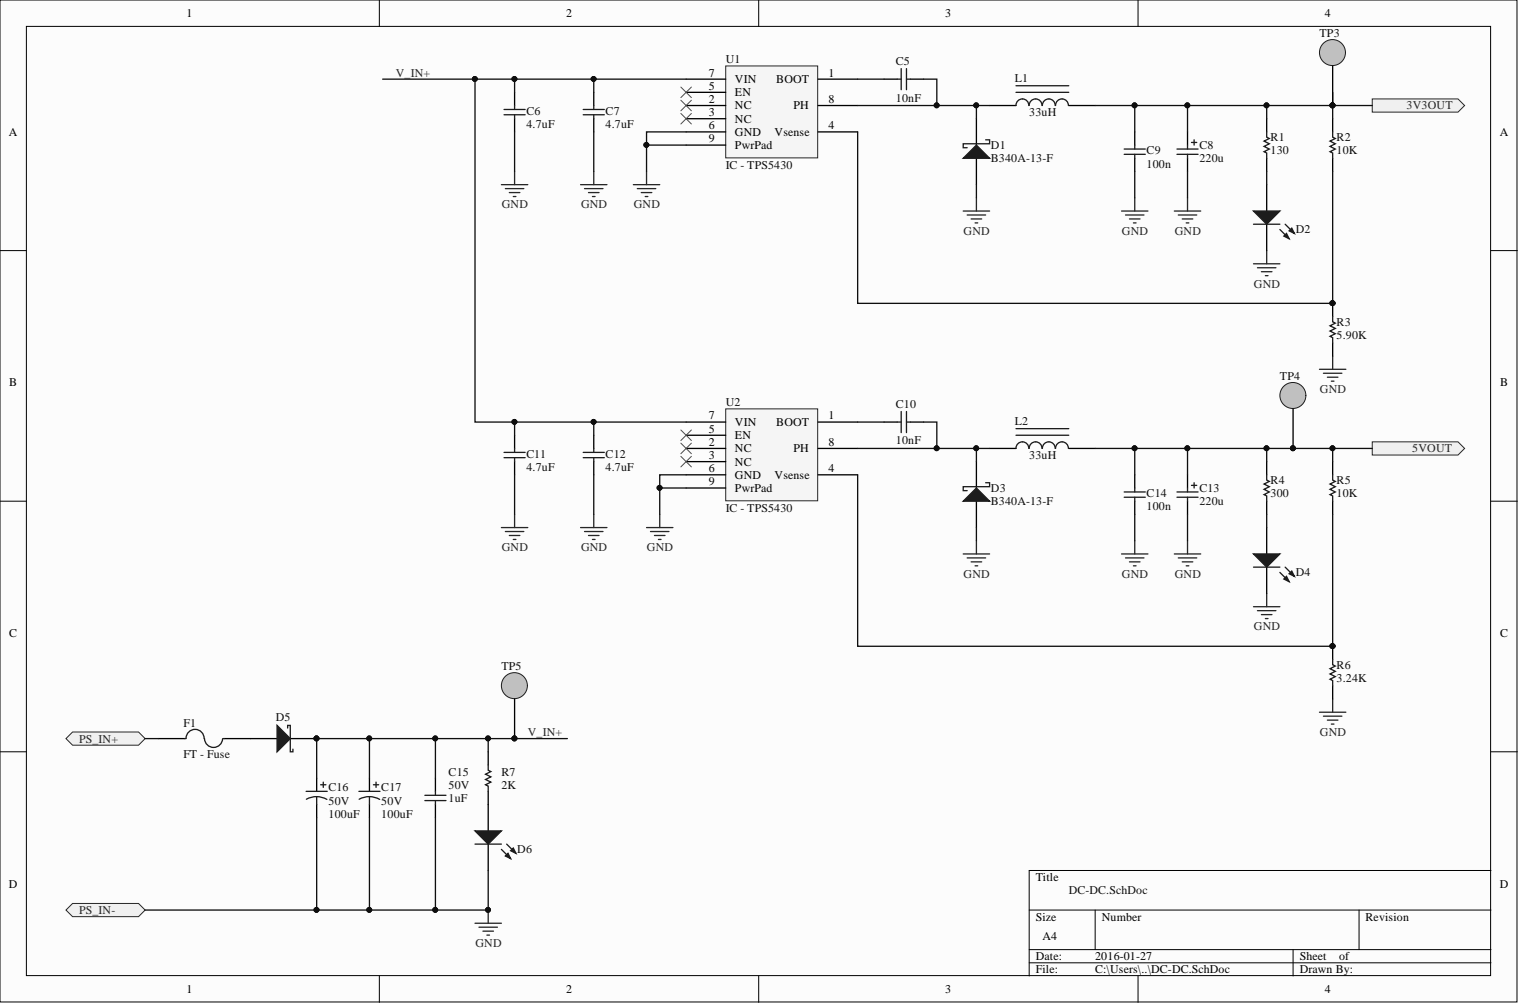
[picture p73: page 2]

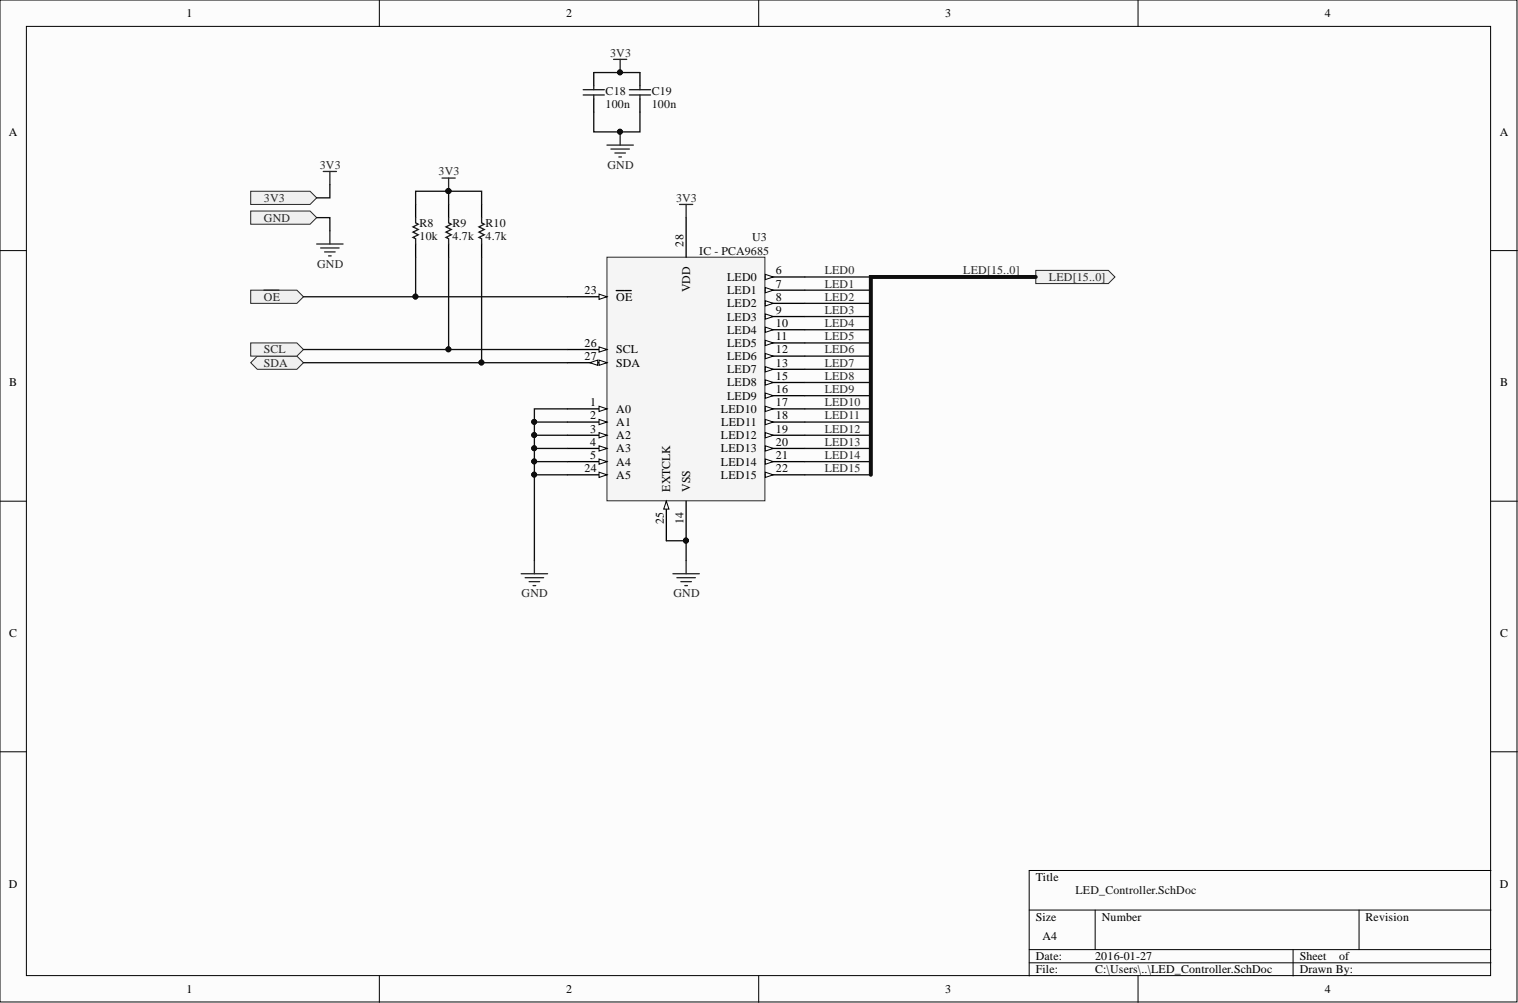
[picture p74: page 3]

2 | 1 8 L E D 1 1
3 | 1 9 L E D 1 2
4 | 2 0 L E D 1 3
5 | 2 1 L E D 1 4
2 4 | 2 2 L E D 1 5

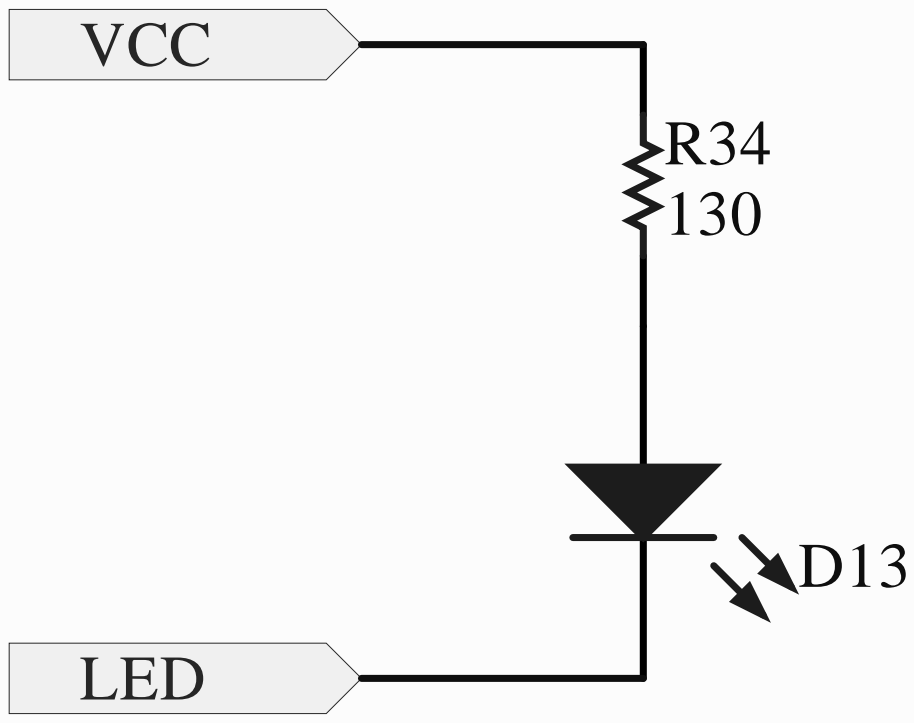
[picture p75: page 4]

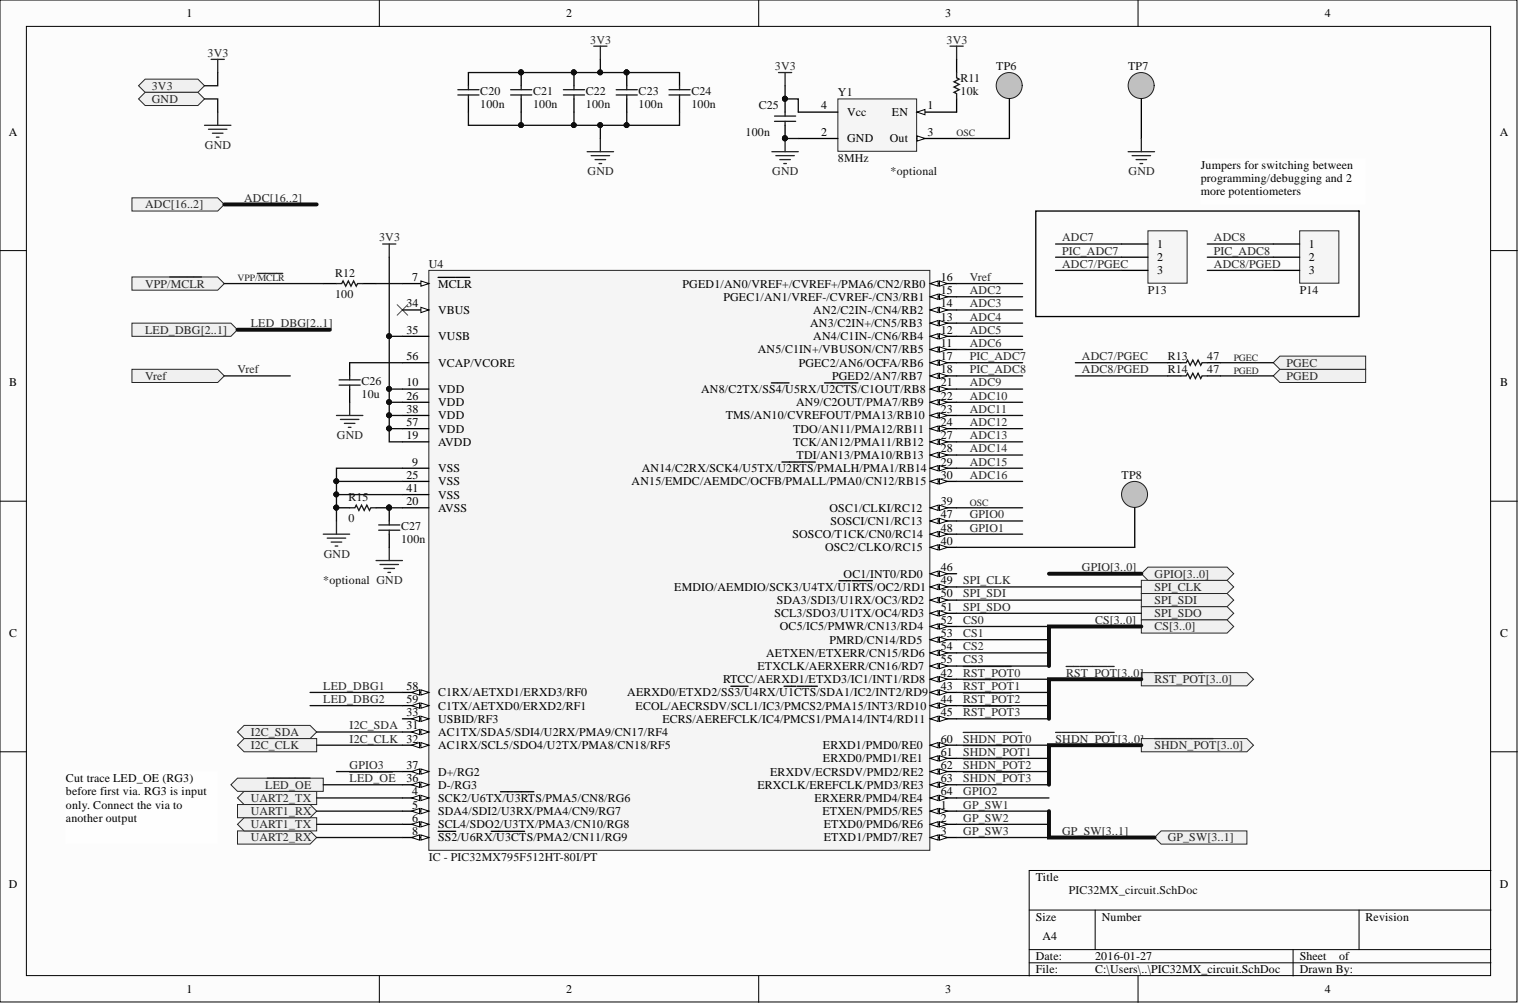
[picture p76: page 5]

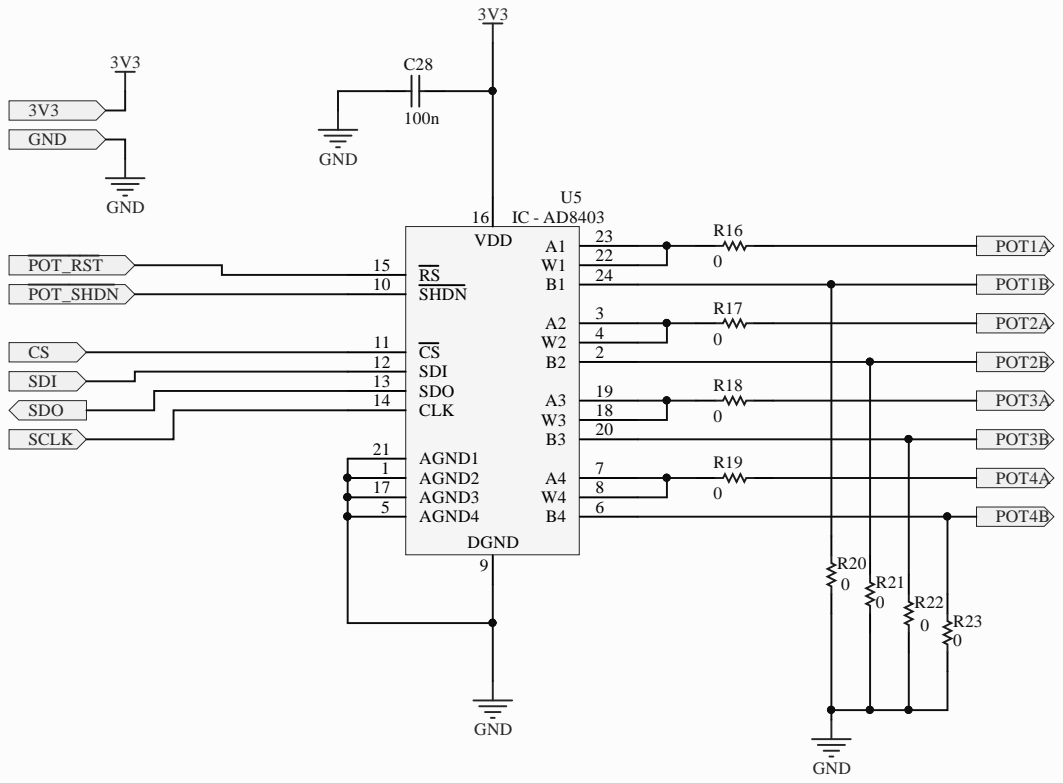
[picture p77: page 6]

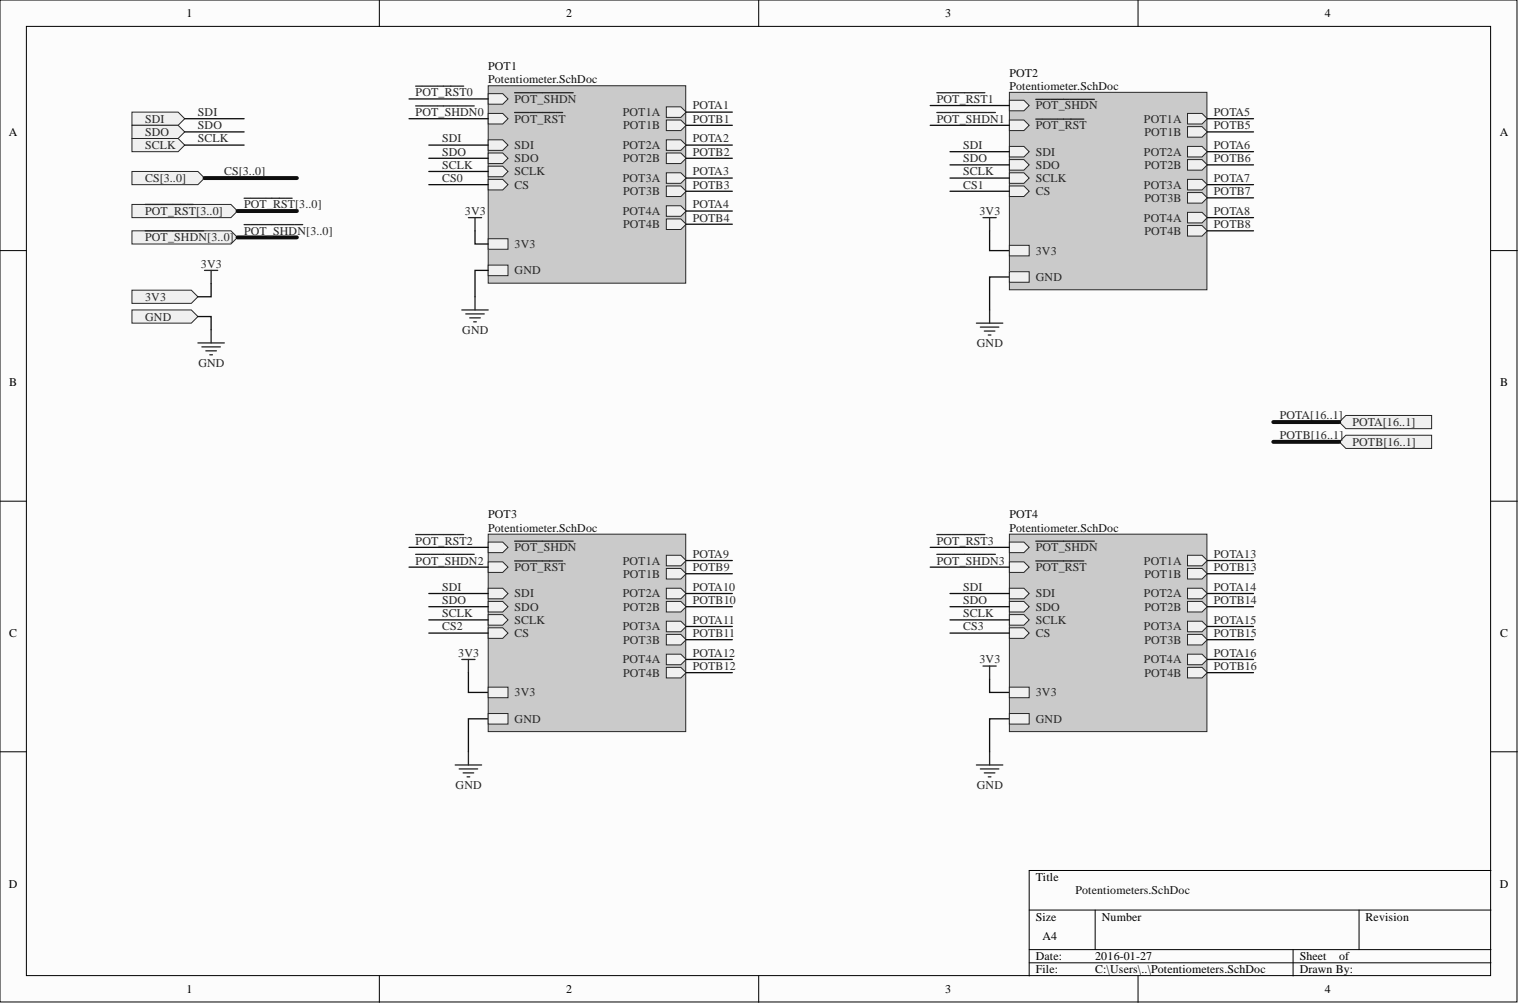
[picture p78: page 7]

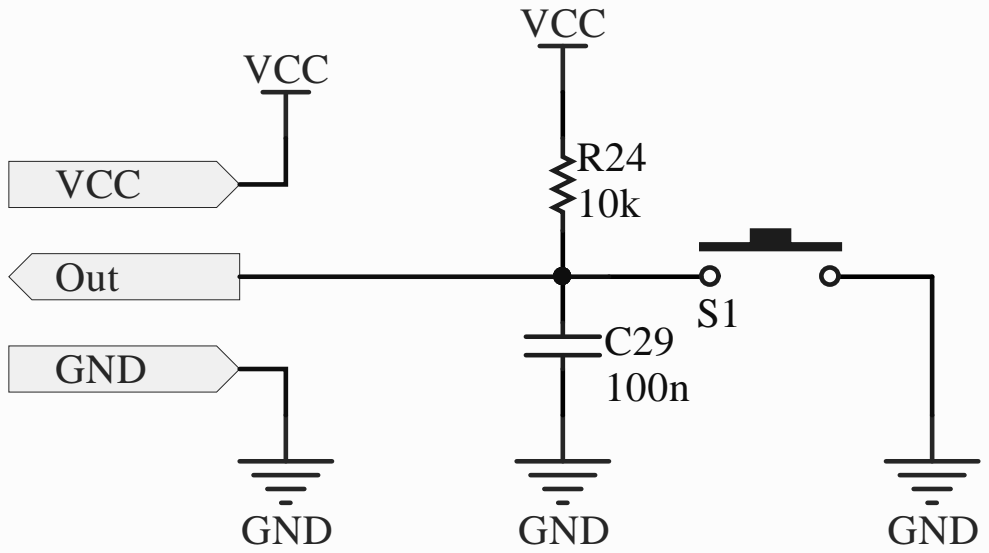
[picture p79: page 8]

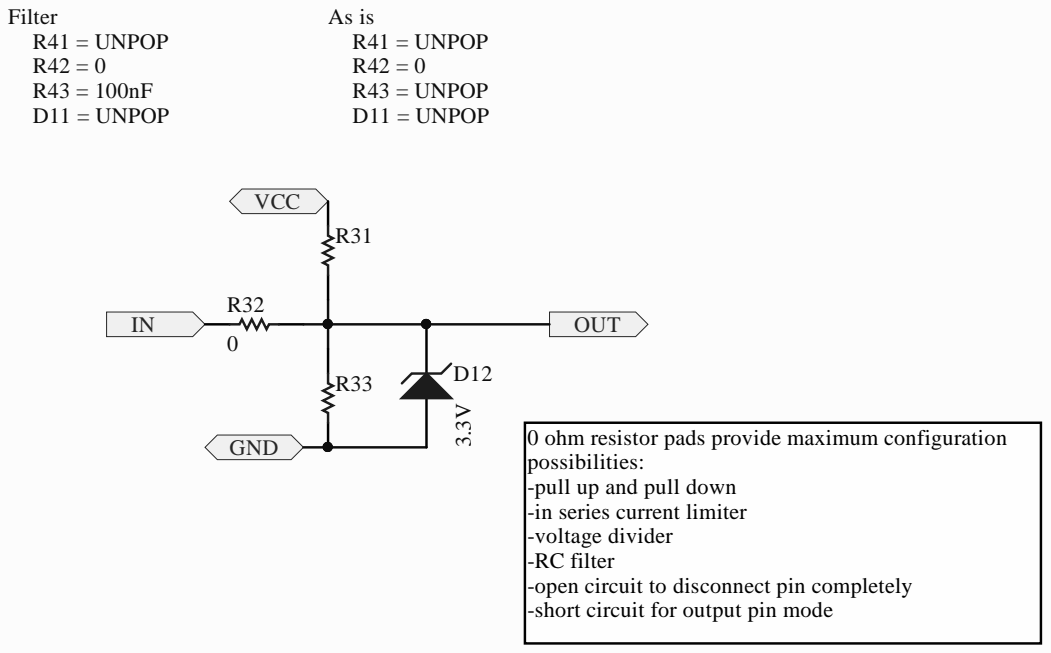
[picture p80: page 9]

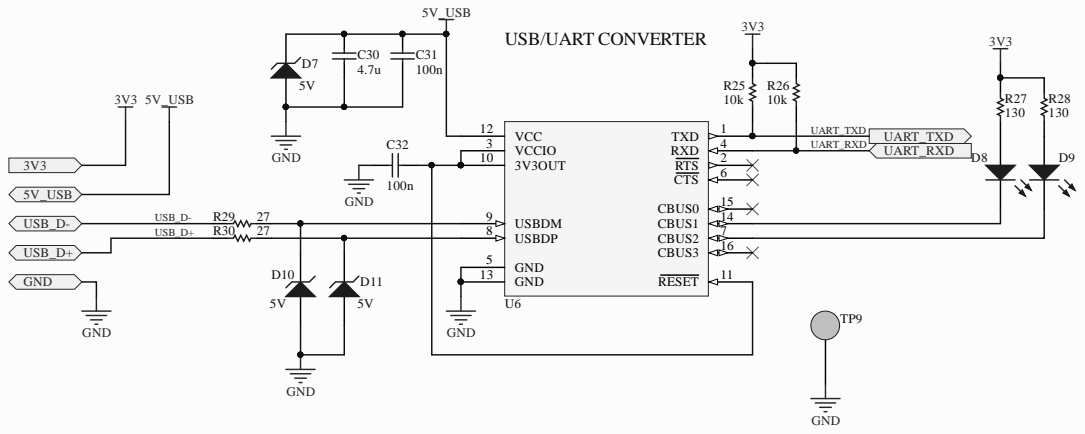
[picture p81: page 10]

1 0 | | 2
9 8 5 G | CT S CBUS0 USBD M CBUS1 USBD P CBUS2 CBUS3 G N D G N D RESE T | 6

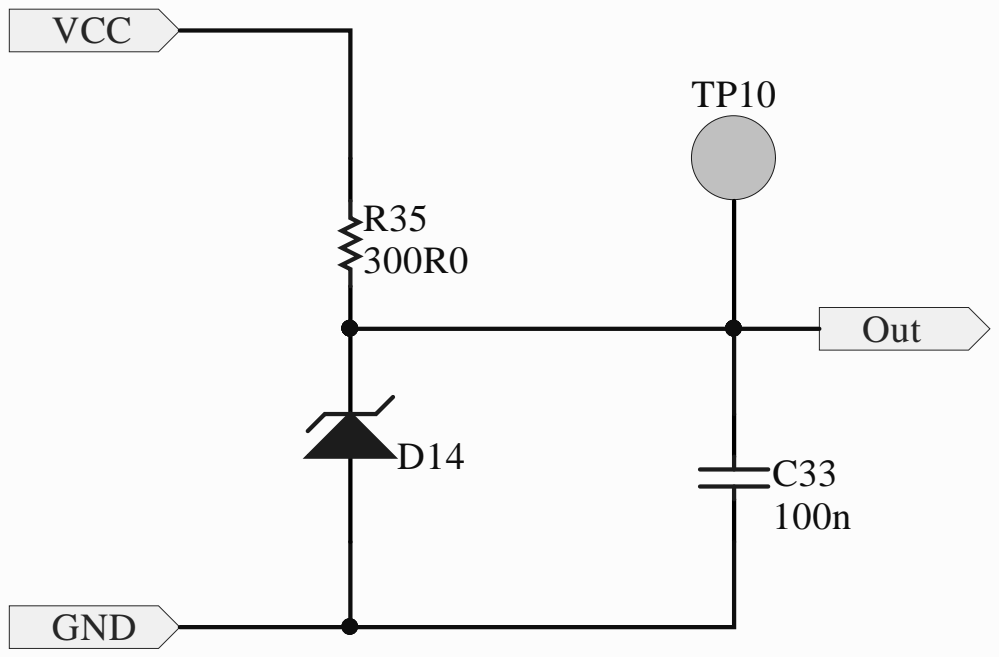
[picture p82: page 11]

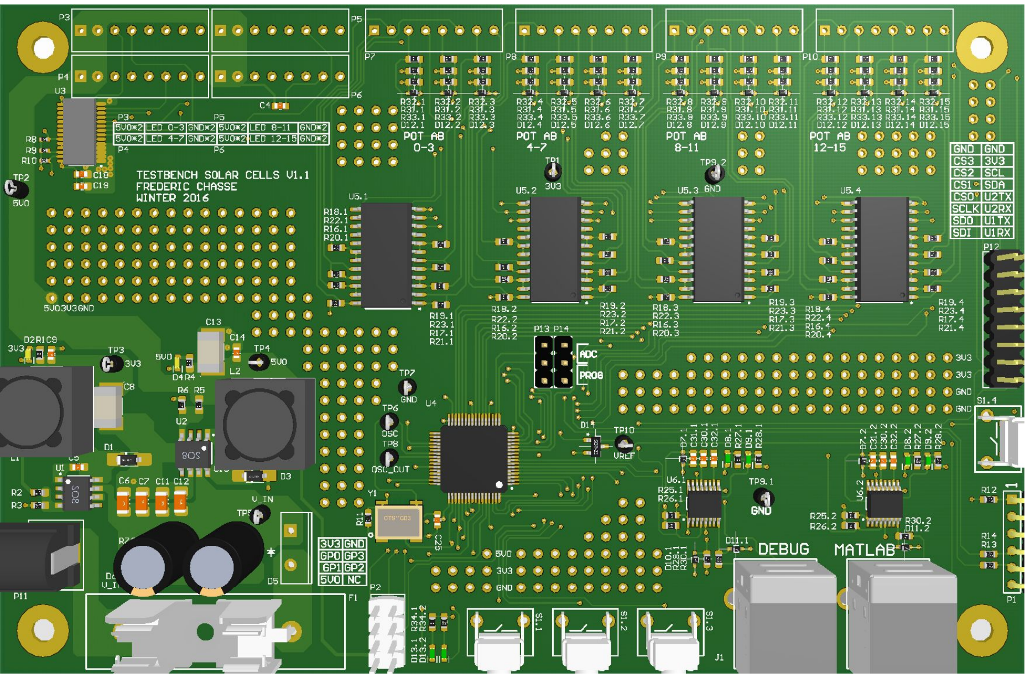
[picture p83: page 12]
