FredericChasse/Testbench_PCB/LedBoardSchematics.PDF

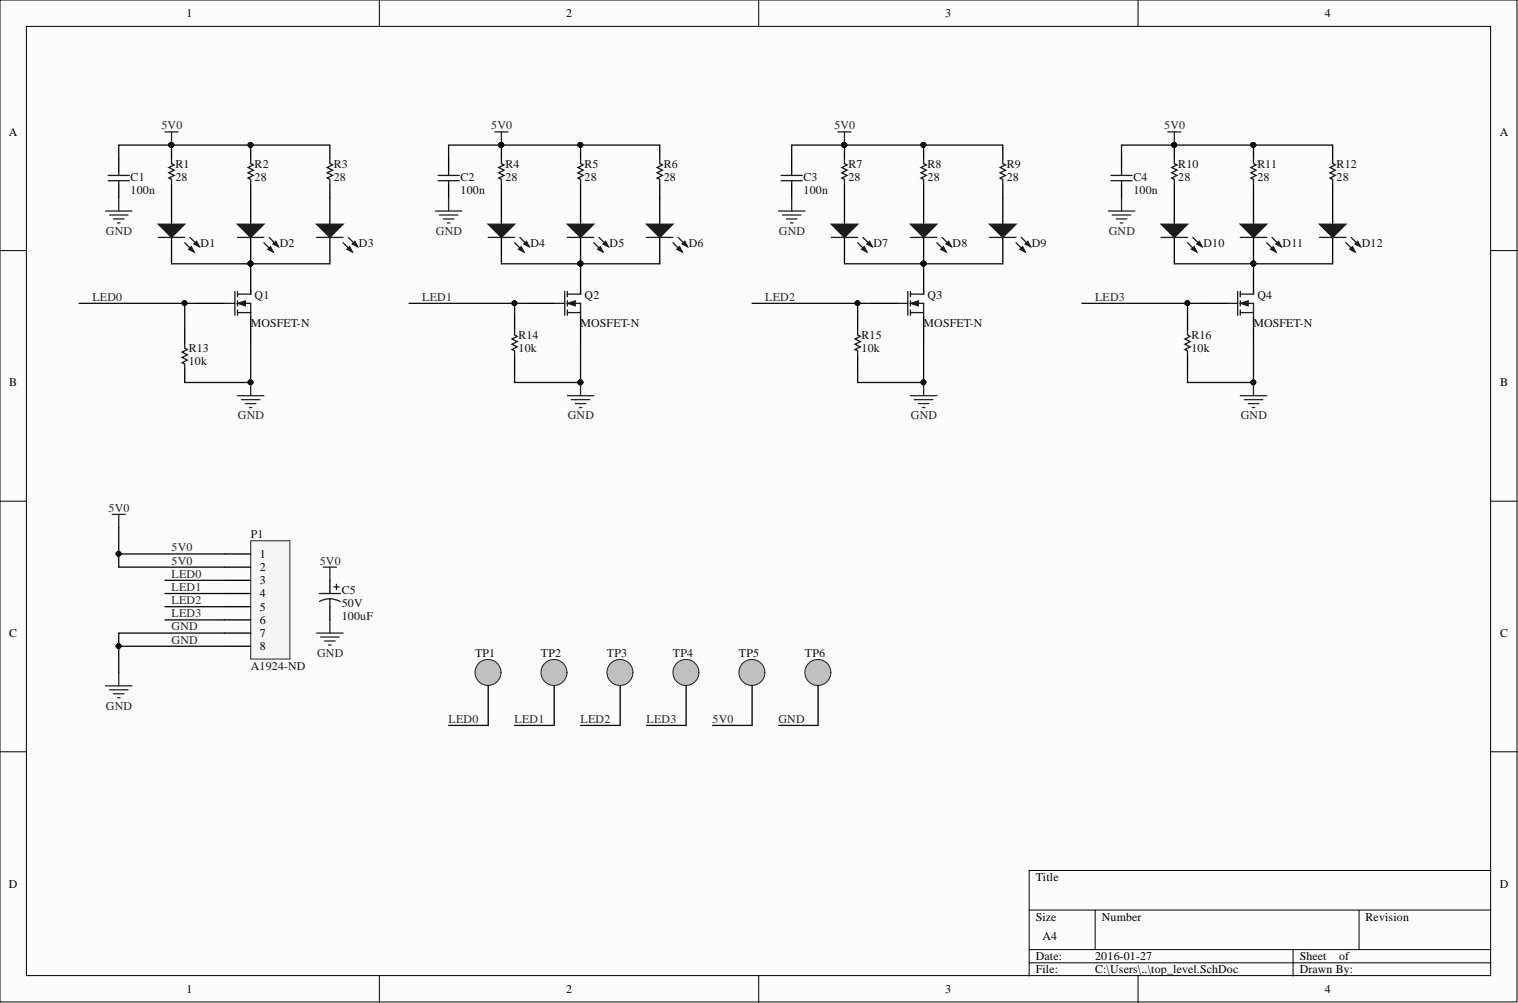
[picture p84: page 1]
