FredericChasse/Testbench_PCB/solar_board/Project Outputs for solar_board/docs.PDF

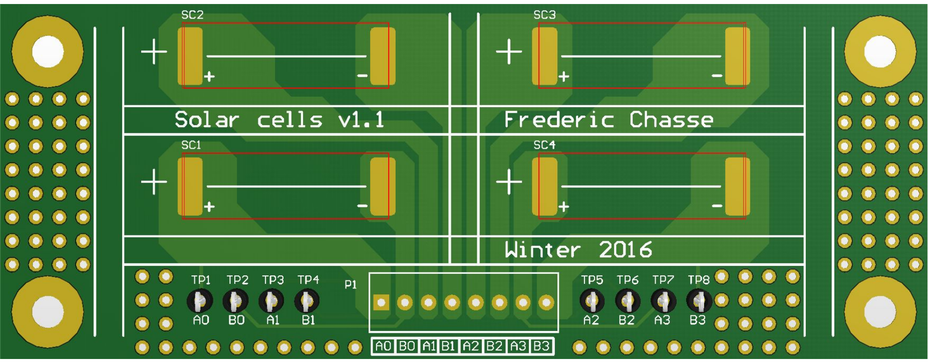
[picture p85: page 1]

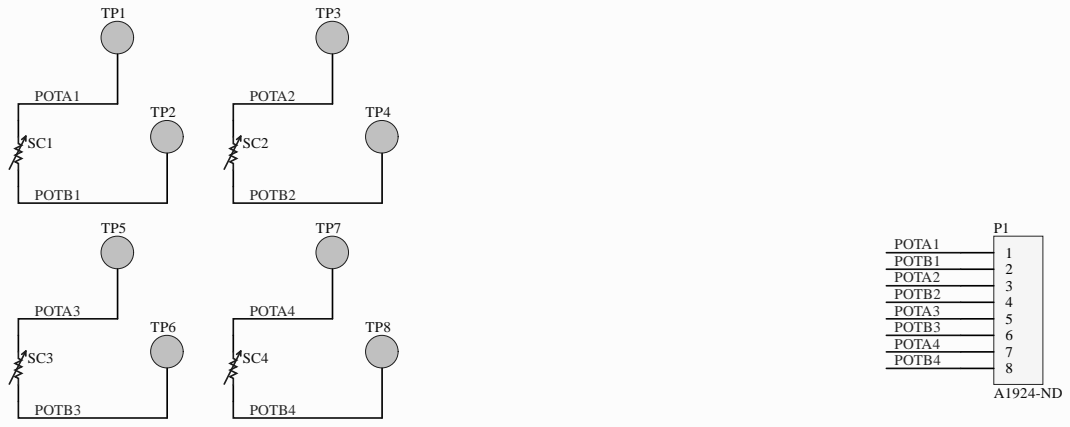
[picture p86: page 2]
