FredericChasse/Testbench_PCB/(list of files, drawings)

Other design files:
Benchtest/Benchtest.PrjPcb
Benchtest/ControlBoard.PcbDoc
Benchtest/ControlBoard.SchDoc
Benchtest/DC-DC.SchDoc
Benchtest/LED_Controller.SchDoc
Benchtest/PIC32MX_circuit.SchDoc
Benchtest/Potentiometer.SchDoc
Benchtest/Potentiometers.SchDoc
Benchtest/Push_Button.SchDoc
Benchtest/Signal_Protection.SchDoc
Benchtest_PIC32/Benchtest_PIC32.PrjPcb
LED_board/LED_board.PrjPcb
LED_board/LED_top_level.PcbDoc
LED_board/top_level.SchDoc
solar_board/solar_board.PrjPcb
solar_board/top_level.PcbDoc
solar_board/top_level.SchDoc
TestbenchPCB_2_0/ADS7952-Q1.SchDoc
TestbenchPCB_2_0/ControlBoard.SchDoc
TestbenchPCB_2_0/ControlBoard_2_0.PrjPCB
TestbenchPCB_2_0/DC-DC.SchDoc
TestbenchPCB_2_0/LED_Controller.SchDoc
TestbenchPCB_2_0/LED_debug.SchDoc
TestbenchPCB_2_0/PGA.SchDoc
TestbenchPCB_2_0/PIC32MX_circuit.SchDoc
TestbenchPCB_2_0/Potentiometer.SchDoc
TestbenchPCB_2_0/Potentiometers.SchDoc
TestbenchPCB_2_0/Power_Enable.SchDoc
TestbenchPCB_2_0/Push_Button.SchDoc
TestbenchPCB_2_0/Signal_Acquisition.SchDoc
TestbenchPCB_2_0/Signal_Protection.SchDoc
TestbenchPCB_2_0/USB-UART.SchDoc
TestbenchPCB_2_0/Vref.SchDoc
