FredericChasse/Testbench_PCB/(commit log)

2017-02-09 Commiting now to new repo, as old one couldn't
    [BOM.xlsx, Base_part.STL, Base_part_v2.STL, Benchtest - v1_0.SLDPRT, Benchtest.PrjPcb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]
2017-02-13 Added new project for control board 2.0
    [ControlBoard.SchDoc, ControlBoard_2_0.PrjPCB, DC-DC.SchDoc, LED_Controller.SchDoc, LED_debug.SchDoc, PIC32MX_circuit.SchDoc, Potentiometer.SchDoc, Potentiometers.SchDoc]
2017-02-13 Corrected the errors from version 1.0
    [ControlBoard.SchDoc, PIC32MX_circuit.SchDoc]
2017-02-13 Removed the solder points on the PCB and started removing the LED controller circuit
    [ControlBoard.SchDoc]
2017-02-13 Removed LED driver and 5V bus
    [ControlBoard.SchDoc, DC-DC.SchDoc, PIC32MX_circuit.SchDoc]
2017-02-13 Removed GPIO connector
    [ControlBoard.SchDoc, ControlBoard_2_0.PrjPCB, PIC32MX_circuit.SchDoc]
2017-02-15 Added circuit for ADC
    [ADS7952-Q1.SchDoc, ControlBoard.SchDoc, ControlBoard_2_0.PrjPCB, PIC32MX_circuit.SchDoc]
